ExcessiveOverkill/drive-software-dev/(list of files, cad)

Other CAD files:
KiCAD Files/HV servo drive v1 PCB.ipt
