ExcessiveOverkill/drive-software-dev/KiCAD Files/HV servo drive v1.kicad_pcb

## KiCad design KiCAD Files/HV servo drive v1.kicad_pcb (2024-05-03)

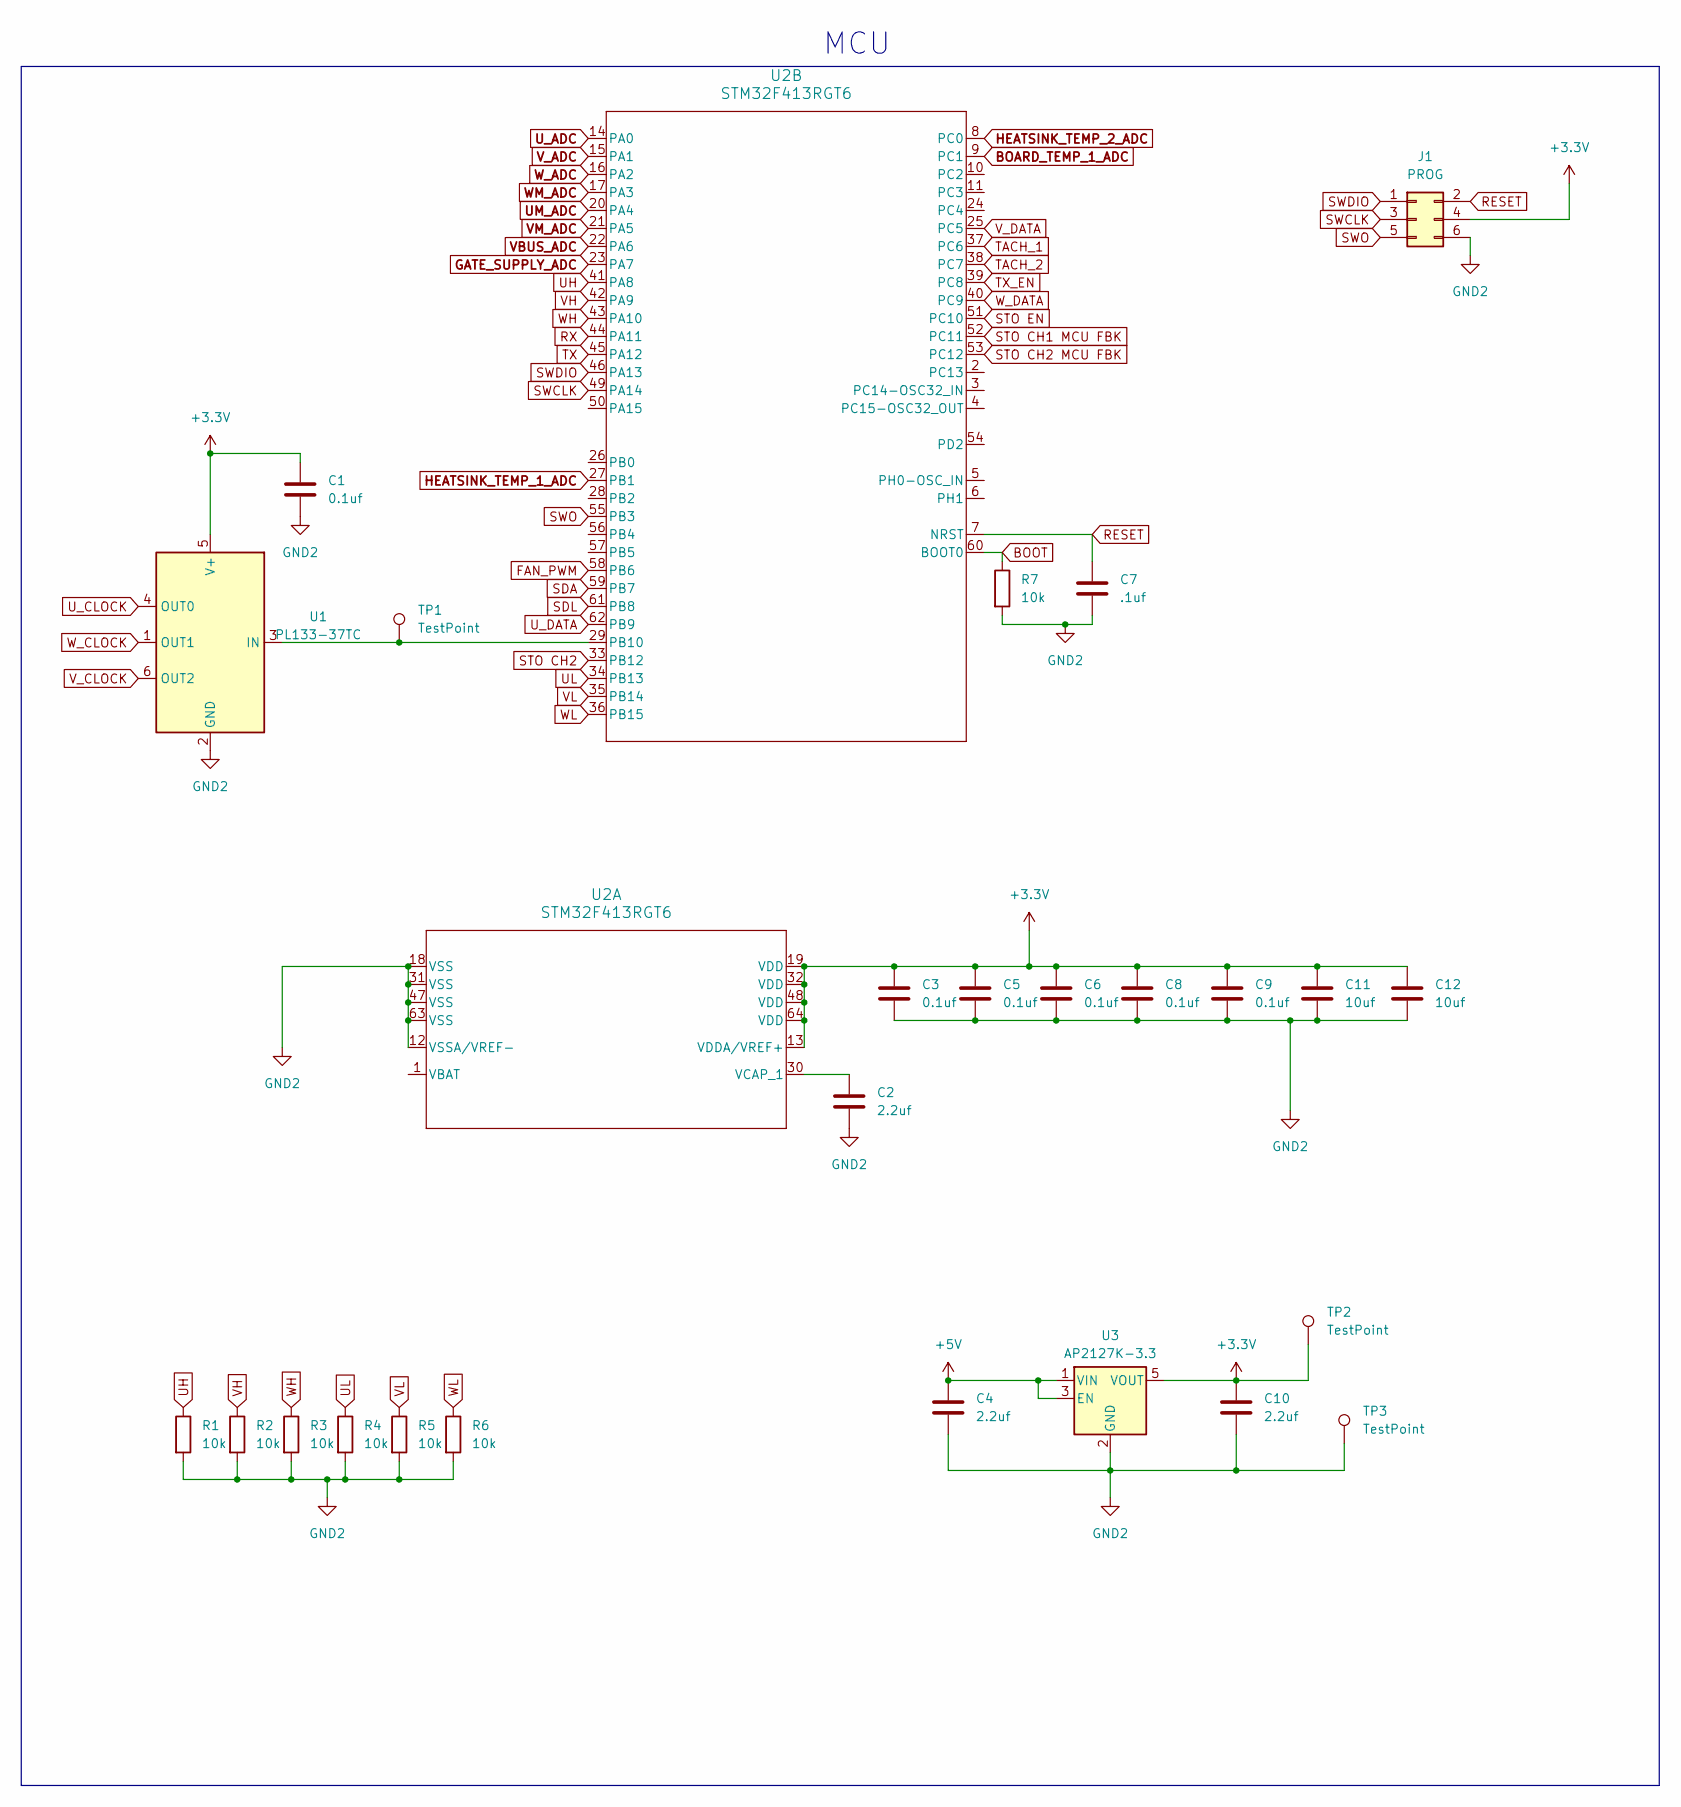
[picture p1: schematic mcu.kicad_sch]

Parts:
C1, C3, C5, C6, C8, C9: 0.1uf; C_0603_1608Metric
C2, C4, C10: 2.2uf; C_0603_1608Metric
C7: .1uf; C_0603_1608Metric
C11, C12: 10uf; C_0805_2012Metric
J1: PROG; PinHeader_2x03_P2.54mm_Vertical
R1, R2, R3, R4, R5, R6, R7: 10k; R_0603_1608Metric
TP1, TP2, TP3: TestPoint; TestPoint_Pad_3.1x1.6mm
U1: PL133-37TC; SOT-23-6
U2: STM32F413RGT6; LQFP64-10x10mm
U3: AP2127K-3.3; SOT-23-5

Connections:
+3.3V: C1.1, C3.1, C5.1, C6.1, C8.1, C9.1, C10.1, C11.1, C12.1, J1.4, TP2.1, U1.5 (V+), U2.13 (VDDA/VREF+), U2.19 (VDD), U2.32 (VDD), U2.48 (VDD), U2.64 (VDD), U3.5 (VOUT); also elsewhere on the board
+5V: C4.1, U3.1 (VIN), U3.3 (EN); also elsewhere on the board
BOARD_TEMP_1_ADC: U2.9 (PC1); also elsewhere on the board
BOOT: R7.1, U2.60 (BOOT0)
FAN_PWM: U2.58 (PB6); also elsewhere on the board
GATE_SUPPLY_ADC: U2.23 (PA7)
GND2: C1.2, C2.2, C3.2, C4.2, C5.2, C6.2, C7.2, C8.2, C9.2, C10.2, C11.2, C12.2, J1.6, R1.2, R2.2, R3.2, R4.2, R5.2, R6.2, R7.2, TP3.1, U1.2 (GND), U2.12 (VSSA/VREF-), U2.18 (VSS), U2.31 (VSS), U2.47 (VSS), U2.63 (VSS), U3.2 (GND); also elsewhere on the board
HEATSINK_TEMP_1_ADC: U2.27 (PB1); also elsewhere on the board
HEATSINK_TEMP_2_ADC: U2.8 (PC0); also elsewhere on the board
unnamed: TP1.1, U1.3 (IN), U2.29 (PB10)
unnamed: C2.1, U2.30 (VCAP_1)
RESET: C7.1, J1.2, U2.7 (NRST)
RX: U2.44 (PA11); also elsewhere on the board
SDA: U2.59 (PB7); also elsewhere on the board
SDL: U2.61 (PB8); also elsewhere on the board
STO CH1 MCU FBK: U2.52 (PC11); also elsewhere on the board
STO CH2: U2.33 (PB12); also elsewhere on the board
STO CH2 MCU FBK: U2.53 (PC12); also elsewhere on the board
STO EN: U2.51 (PC10); also elsewhere on the board
SWCLK: J1.3, U2.49 (PA14)
SWDIO: J1.1, U2.46 (PA13)
SWO: J1.5, U2.55 (PB3)
TACH_1: U2.37 (PC6); also elsewhere on the board
TACH_2: U2.38 (PC7); also elsewhere on the board
TX: U2.45 (PA12); also elsewhere on the board
TX_EN: U2.39 (PC8); also elsewhere on the board
UH: R1.1, U2.41 (PA8); also elsewhere on the board
UL: R4.1, U2.34 (PB13); also elsewhere on the board
UM_ADC: U2.20 (PA4); also elsewhere on the board
U_ADC: U2.14 (PA0); also elsewhere on the board
U_CLOCK: U1.4 (OUT0); also elsewhere on the board
U_DATA: U2.62 (PB9); also elsewhere on the board
VBUS_ADC: U2.22 (PA6); also elsewhere on the board
VH: R2.1, U2.42 (PA9); also elsewhere on the board
VL: R5.1, U2.35 (PB14); also elsewhere on the board
VM_ADC: U2.21 (PA5); also elsewhere on the board
V_ADC: U2.15 (PA1); also elsewhere on the board
V_CLOCK: U1.6 (OUT2); also elsewhere on the board
V_DATA: U2.25 (PC5); also elsewhere on the board
WH: R3.1, U2.43 (PA10); also elsewhere on the board
WL: R6.1, U2.36 (PB15); also elsewhere on the board
WM_ADC: U2.17 (PA3); also elsewhere on the board
W_ADC: U2.16 (PA2); also elsewhere on the board
W_CLOCK: U1.1 (OUT1); also elsewhere on the board
W_DATA: U2.40 (PC9); also elsewhere on the board

Notes on the sheet:
MCU

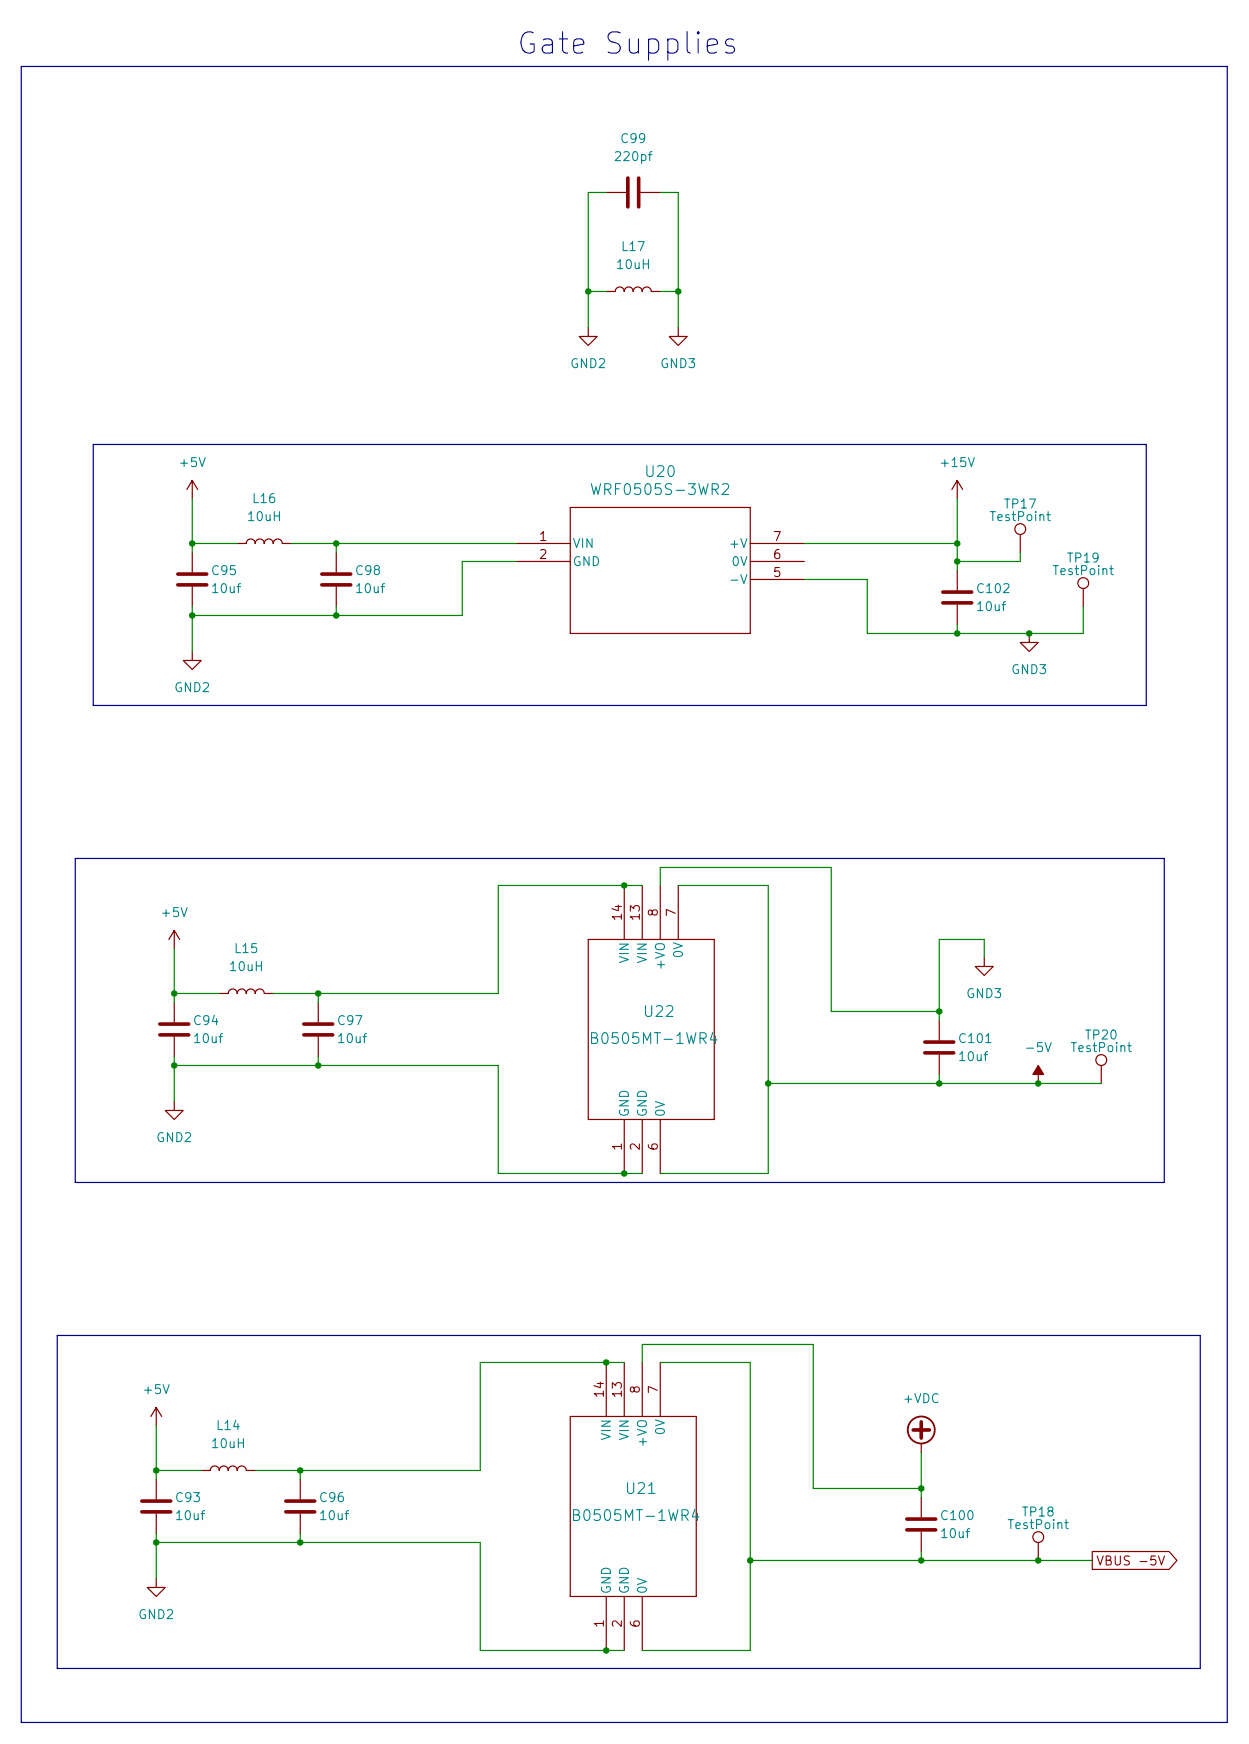
[picture p2: schematic gate supplies.kicad_sch]

Parts:
C93, C94, C95, C96, C97, C98, C100, C101, C102: 10uf; C_0805_2012Metric
C99: 220pf; C_0603_1608Metric
L14, L15, L16, L17: 10uH; L_1008_2520Metric
TP17, TP18, TP19, TP20: TestPoint; TestPoint_Pad_3.1x1.6mm
U20: WRF0505S-3WR2; B0515
U21, U22: B0505MT-1WR4; B05xxMT-1WR4_MNS

Connections:
+5V: C93.1, C94.1, C95.1, L14.1, L15.1, L16.1; also elsewhere on the board
+15V: C102.1, TP17.1, U20.7 (+V); also elsewhere on the board
+VDC: C100.1, U21.8 (+VO); also elsewhere on the board
-5V: C101.2, TP20.1, U22.6 (0V), U22.7 (0V); also elsewhere on the board
GND2: C93.2, C94.2, C95.2, C96.2, C97.2, C98.2, C99.2, L17.1, U20.2 (GND), U21.1 (GND), U21.2 (GND), U22.1 (GND), U22.2 (GND); also elsewhere on the board
GND3: C99.1, C101.1, C102.2, L17.2, TP19.1, U20.5 (-V), U22.8 (+VO); also elsewhere on the board
unnamed: C96.1, L14.2, U21.13 (VIN), U21.14 (VIN)
unnamed: C97.1, L15.2, U22.13 (VIN), U22.14 (VIN)
unnamed: C98.1, L16.2, U20.1 (VIN)
VBUS -5V: C100.2, TP18.1, U21.6 (0V), U21.7 (0V); also elsewhere on the board

Notes on the sheet:
Gate Supplies

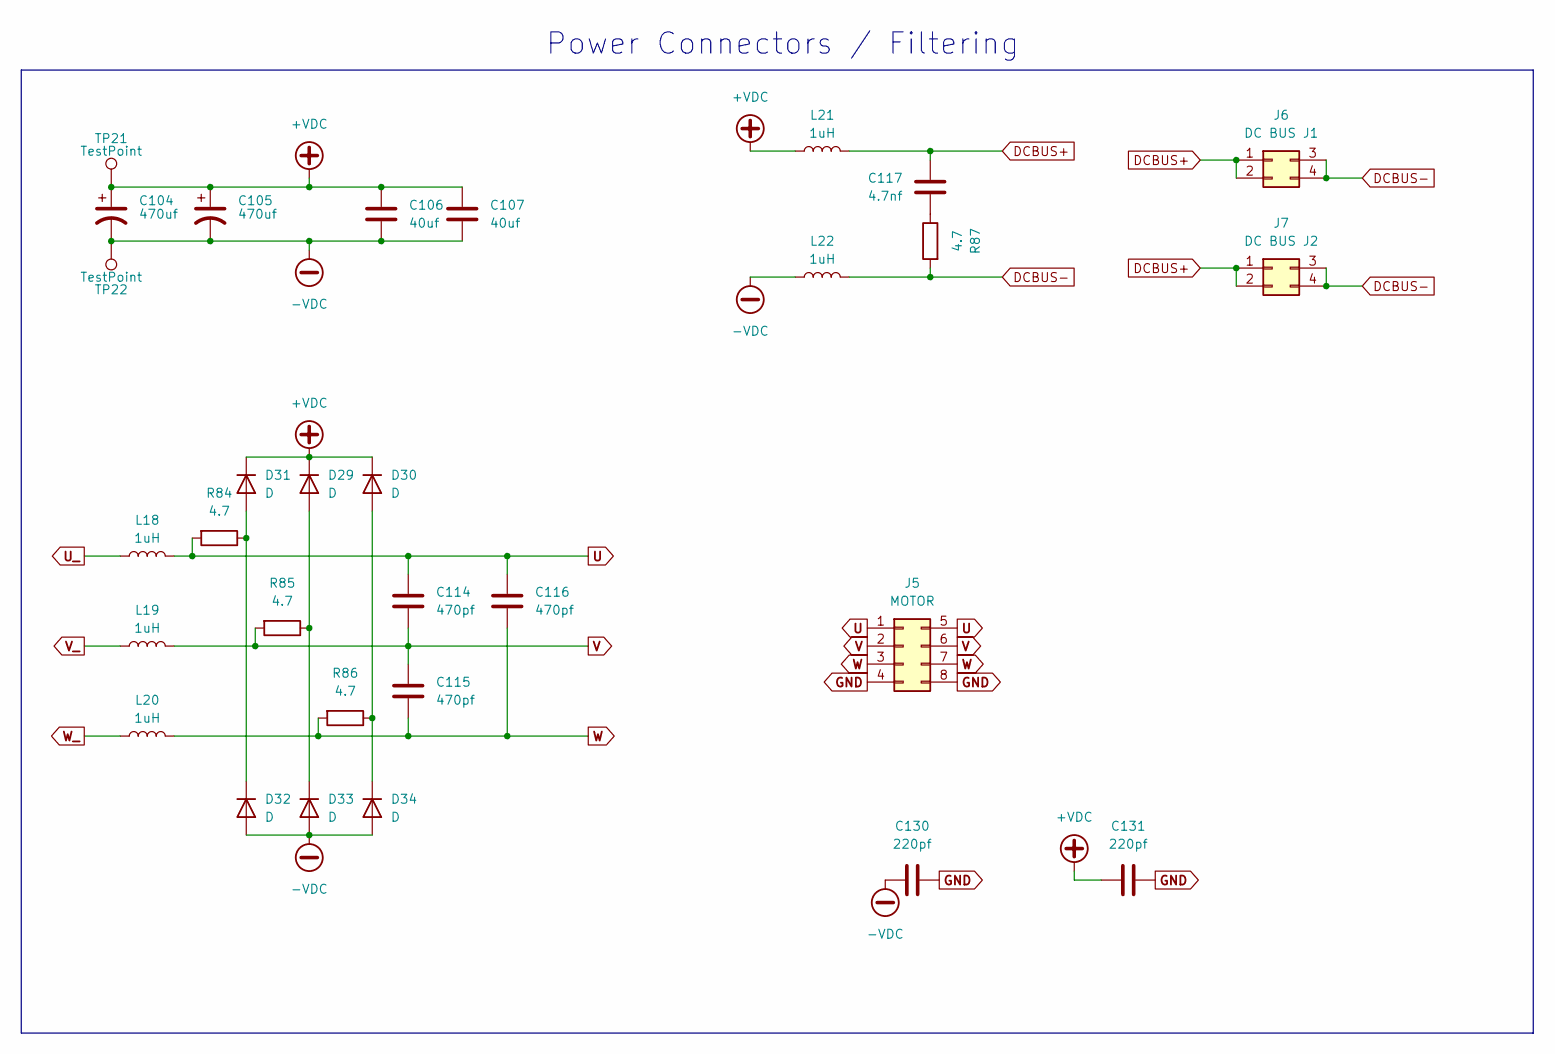
[picture p3: schematic power connectors.kicad_sch]

Parts:
C104, C105: 470uf; CP_Radial_D30.0mm_P10.00mm_SnapIn
C106, C107: 40uf; BUS CAP1
C114, C115, C116: 470pf; C_1206_3216Metric
C117: 4.7nf; C_1206_3216Metric
C130, C131: 220pf; C_Disc_D7.5mm_W5.0mm_P10.00mm
D29, D30, D31, D32, D33, D34: D; D_SMC
J5: MOTOR; Molex_Mega-Fit_76825-0008_2x04_P5.70mm_Horizontal
J6: DC BUS J1; Molex_Mega-Fit_76825-0004_2x02_P5.70mm_Horizontal
J7: DC BUS J2; Molex_Mega-Fit_76825-0004_2x02_P5.70mm_Horizontal
L18, L19, L20: 1uH; L_Vishay_IHLP-6767
L21, L22: 1uH; L_Vishay_IHLP-5050
R84, R85, R86, R87: 4.7; R_1206_3216Metric_Wide
TP21, TP22: TestPoint; TestPoint_Pad_3.1x1.6mm

Connections:
+VDC: C104.1, C105.1, C106.1, C107.1, C131.2, D29.1 (K), D30.1 (K), D31.1 (K), L21.2, TP21.1; also elsewhere on the board
-VDC: C104.2, C105.2, C106.2, C107.2, C130.2, D32.2 (A), D33.2 (A), D34.2 (A), L22.2, TP22.1; also elsewhere on the board
DCBUS+: C117.1, J6.1, J6.2, J7.1, J7.2, L21.1
DCBUS-: J6.3, J6.4, J7.3, J7.4, L22.1, R87.2
GND: C130.1, C131.1, J5.4, J5.8; also elsewhere on the board
unnamed: C117.2, R87.1
unnamed: D29.2 (A), D33.1 (K), R85.1
unnamed: D30.2 (A), D34.1 (K), R86.1
unnamed: D31.2 (A), D32.1 (K), R84.1
U: C114.1, C116.1, J5.1, J5.5, L18.2, R84.2; also elsewhere on the board
U_: L18.1; also elsewhere on the board
V: C114.2, C115.1, J5.2, J5.6, L19.2, R85.2; also elsewhere on the board
V_: L19.1; also elsewhere on the board
W: C115.2, C116.2, J5.3, J5.7, L20.2, R86.2; also elsewhere on the board
W_: L20.1; also elsewhere on the board

Notes on the sheet:
Power Connectors / Filtering

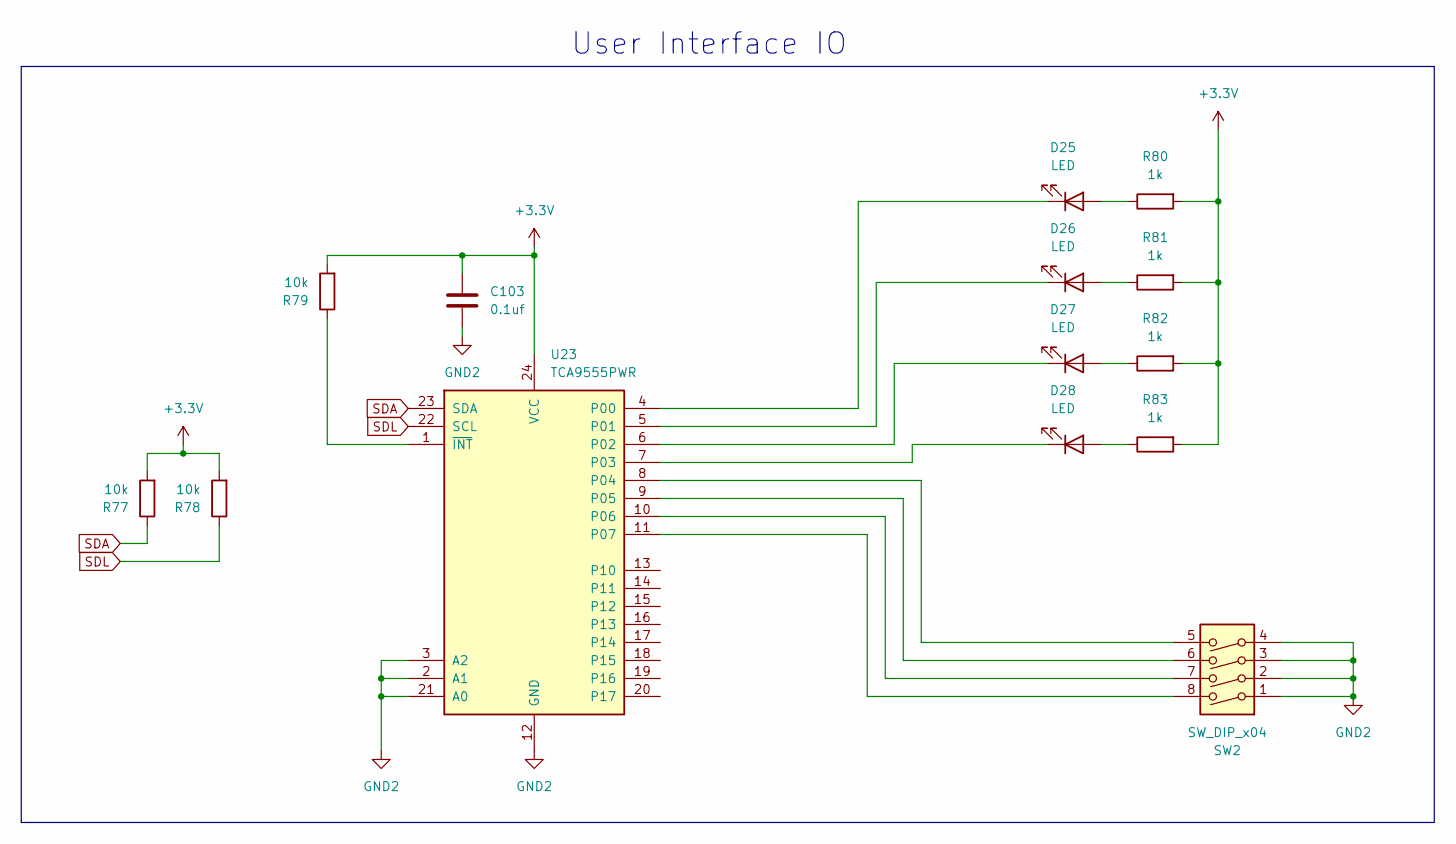
[picture p4: schematic user io.kicad_sch]

Parts:
C103: 0.1uf; C_0603_1608Metric
D25, D26, D27, D28: LED; LED_0603_1608Metric
R77, R78, R79: 10k; R_0603_1608Metric
R80, R81, R82, R83: 1k; R_0603_1608Metric
SW2: SW_DIP_x04; DIP-8_W7.62mm
U23: TCA9555PWR; TSSOP-24_4.4x7.8mm_P0.65mm

Connections:
+3.3V: C103.1, R77.2, R78.2, R79.2, R80.2, R81.2, R82.2, R83.2, U23.24 (VCC); also elsewhere on the board
GND2: C103.2, SW2.1, SW2.2, SW2.3, SW2.4, U23.2 (A1), U23.3 (A2), U23.12 (GND), U23.21 (A0); also elsewhere on the board
unnamed: D25.2 (A), R80.1
unnamed: D25.1 (K), U23.4 (P00)
unnamed: D26.2 (A), R81.1
unnamed: D26.1 (K), U23.5 (P01)
unnamed: D27.2 (A), R82.1
unnamed: D27.1 (K), U23.6 (P02)
unnamed: D28.2 (A), R83.1
unnamed: D28.1 (K), U23.7 (P03)
unnamed: SW2.5, U23.8 (P04)
unnamed: SW2.6, U23.9 (P05)
unnamed: SW2.7, U23.10 (P06)
unnamed: SW2.8, U23.11 (P07)
unnamed: R79.1, U23.1 (~INT)
SDA: R77.1, U23.23 (SDA); also elsewhere on the board
SDL: R78.1, U23.22 (SCL); also elsewhere on the board

Notes on the sheet:
User Interface IO

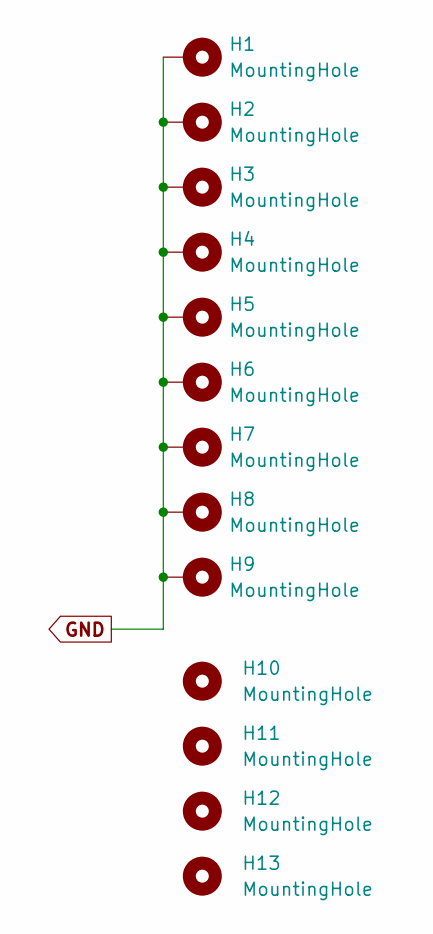
[picture p5: schematic mounting.kicad_sch]

Parts:
H1, H2, H3, H4, H5, H6, H7, H8, H9, H10, H11, H12, H13: MountingHole; MountingHole_3.2mm_M3_Pad_TopBottom_LargeIsolation

Connections:
GND: H1.1, H2.1, H3.1, H4.1, H5.1, H6.1, H7.1, H8.1, H9.1; also elsewhere on the board

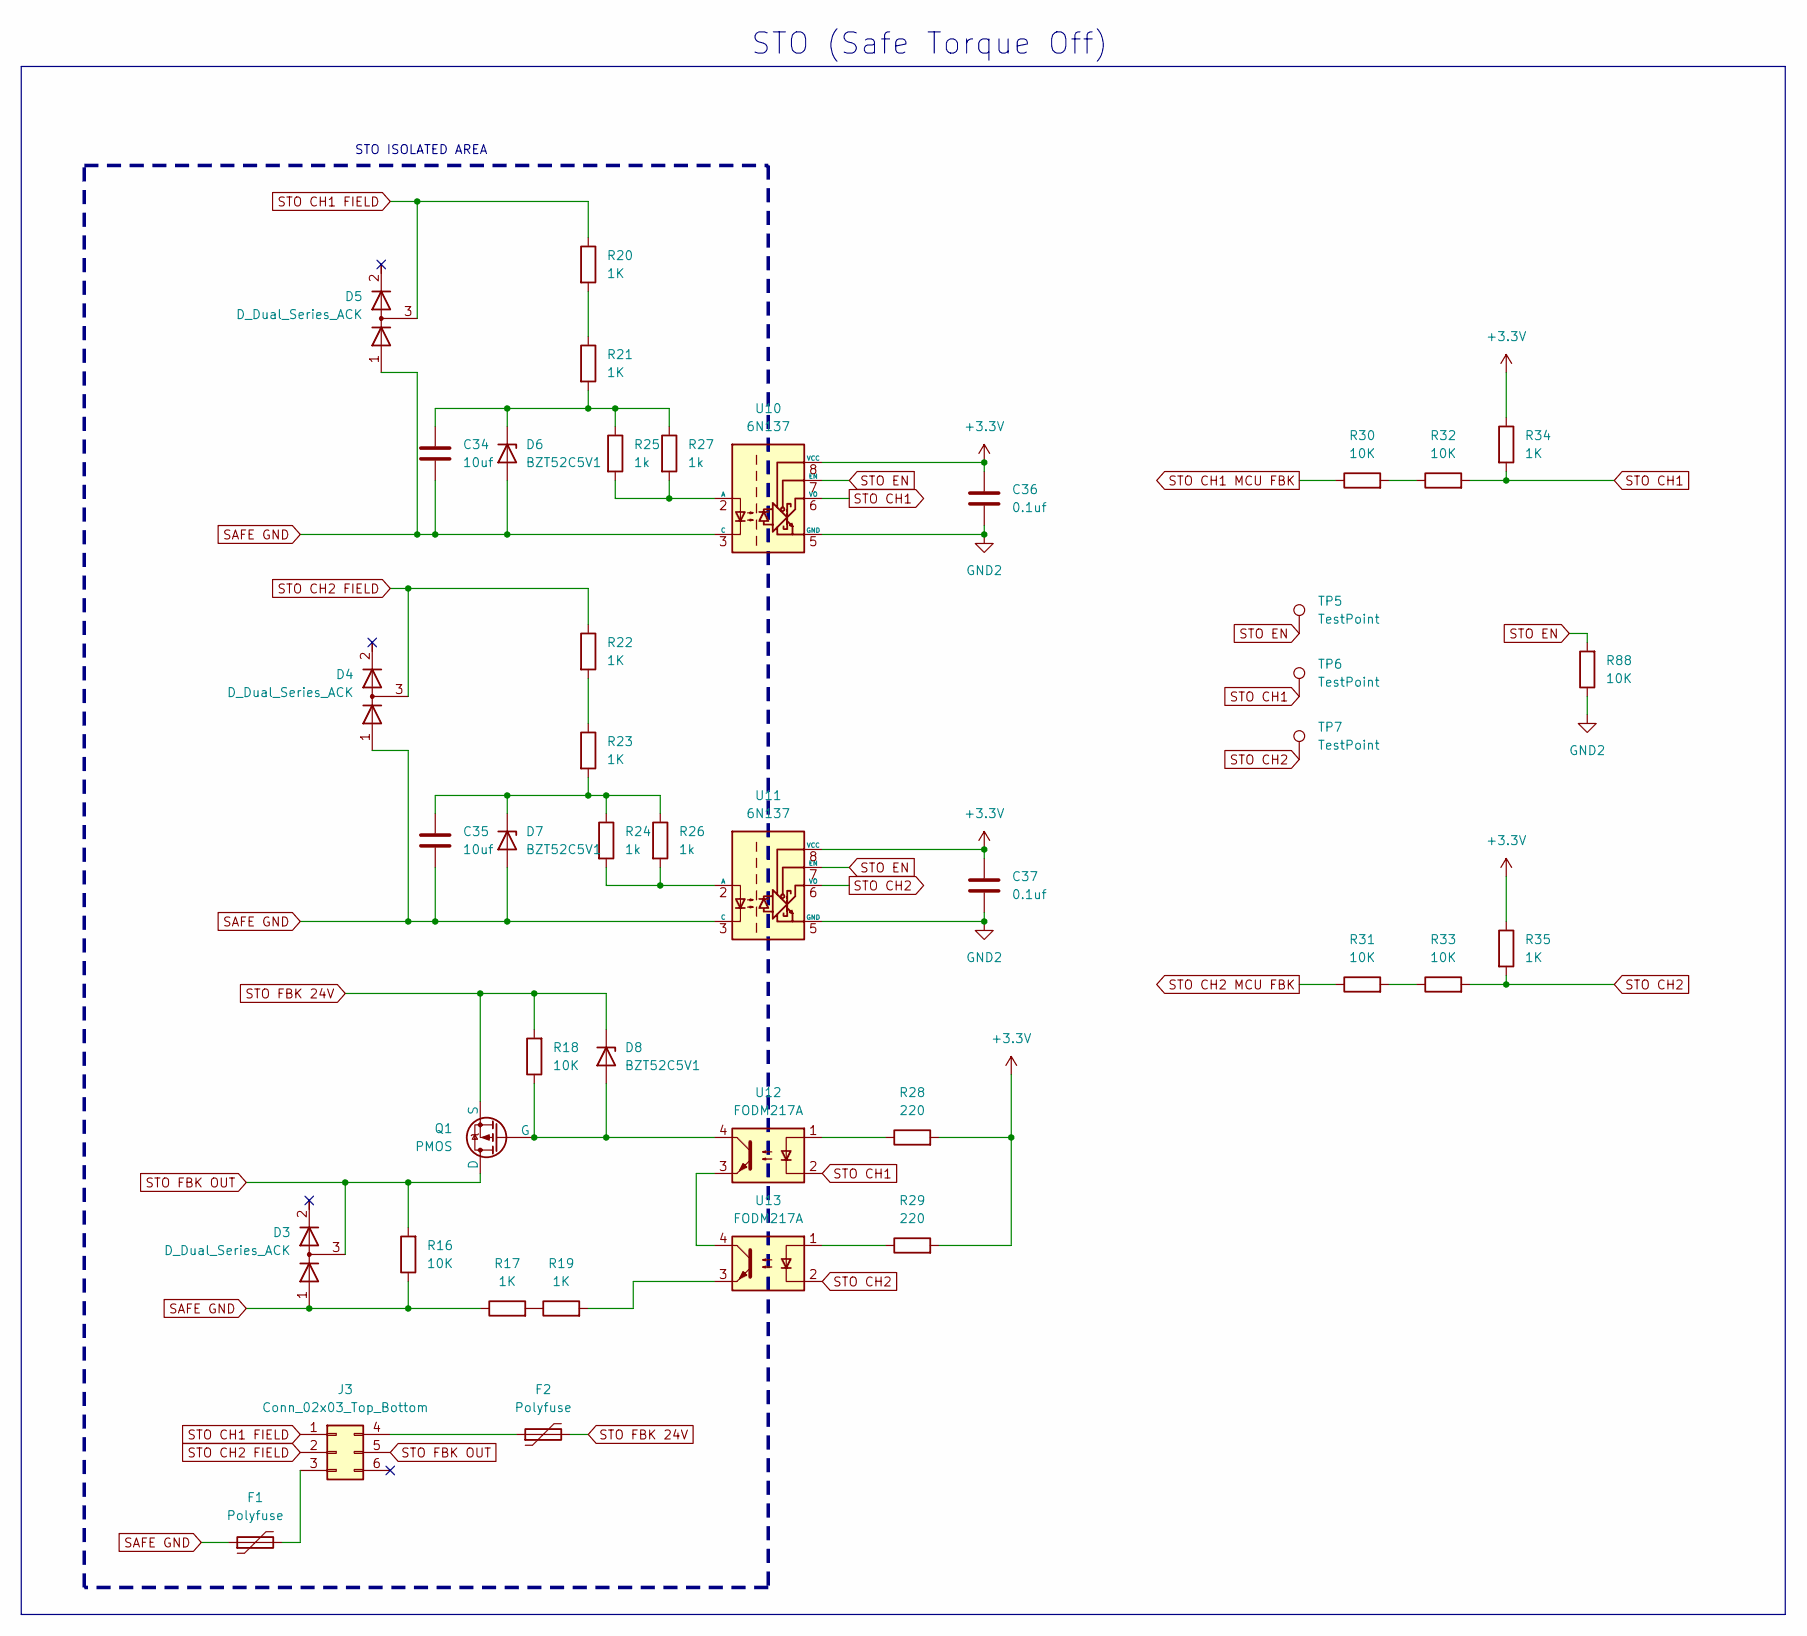
[picture p6: schematic sto.kicad_sch]

Parts:
C34, C35: 10uf; C_0805_2012Metric
C36, C37: 0.1uf; C_0603_1608Metric
D3, D4, D5: D_Dual_Series_ACK; SOT-23
D6, D7, D8: BZT52C5V1; D_SOD-123
F1, F2: Polyfuse; Fuse_1206_3216Metric
J3: Conn_02x03_Top_Bottom; Molex_Mini-Fit_Jr_5569-06A2_2x03_P4.20mm_Horizontal
Q1: PMOS; SOIC-8_3.9x4.9mm_P1.27mm
R16, R18, R30, R31, R32, R33, R88: 10K; R_0603_1608Metric
R17, R19, R20, R21, R22, R23, R34, R35: 1K; R_0603_1608Metric
R24, R25, R26, R27: 1k; R_0603_1608Metric
R28, R29: 220; R_0603_1608Metric
TP5, TP6, TP7: TestPoint; TestPoint_Pad_3.1x1.6mm
U10, U11: 6N137; 6N137S_LTO
U12, U13: FODM217A; SOP-4_4.4x2.6mm_P1.27mm

Connections:
+3.3V: C36.1, C37.1, R28.2, R29.2, R34.1, R35.1, U10.8 (VCC), U11.8 (VCC); also elsewhere on the board
GND2: C36.2, C37.2, R88.1, U10.5 (GND), U11.5 (GND); also elsewhere on the board
unnamed: C34.1, D6.1 (K), R21.2, R25.1, R27.1
unnamed: C35.1, D7.1 (K), R23.2, R24.1, R26.1
unnamed: D8.2 (A), Q1.4 (G), R18.1, U12.4
unnamed: F1.2, J3.3
unnamed: F2.1, J3.4
unnamed: R17.2, R19.1
unnamed: R19.2, U13.3
unnamed: R20.2, R21.1
unnamed: R22.2, R23.1
unnamed: R28.1, U12.1
unnamed: R29.1, U13.1
unnamed: R30.2, R32.1
unnamed: R31.2, R33.1
unnamed: R25.2, R27.2, U10.2 (A)
unnamed: R24.2, R26.2, U11.2 (A)
unnamed: U12.3, U13.4
SAFE GND: C34.2, C35.2, D3.1 (A), D4.1 (A), D5.1 (A), D6.2 (A), D7.2 (A), F1.1, R16.1, R17.1, U10.3 (C), U11.3 (C)
STO CH1: R32.2, R34.2, TP6.1, U10.6 (VO), U12.2; also elsewhere on the board
STO CH1 FIELD: D5.3 (common), J3.1, R20.1
STO CH1 MCU FBK: R30.1; also elsewhere on the board
STO CH2: R33.2, R35.2, TP7.1, U11.6 (VO), U13.2; also elsewhere on the board
STO CH2 FIELD: D4.3 (common), J3.2, R22.1
STO CH2 MCU FBK: R31.1; also elsewhere on the board
STO EN: R88.2, TP5.1, U10.7 (EN), U11.7 (EN); also elsewhere on the board
STO FBK 24V: D8.1 (K), F2.2, Q1.1 (S), Q1.2 (S), Q1.3 (S), R18.2
STO FBK OUT: D3.3 (common), J3.5, Q1.5 (D), Q1.6 (D), Q1.7 (D), Q1.8 (D), R16.2

Notes on the sheet:
STO (Safe Torque Off)
STO ISOLATED AREA

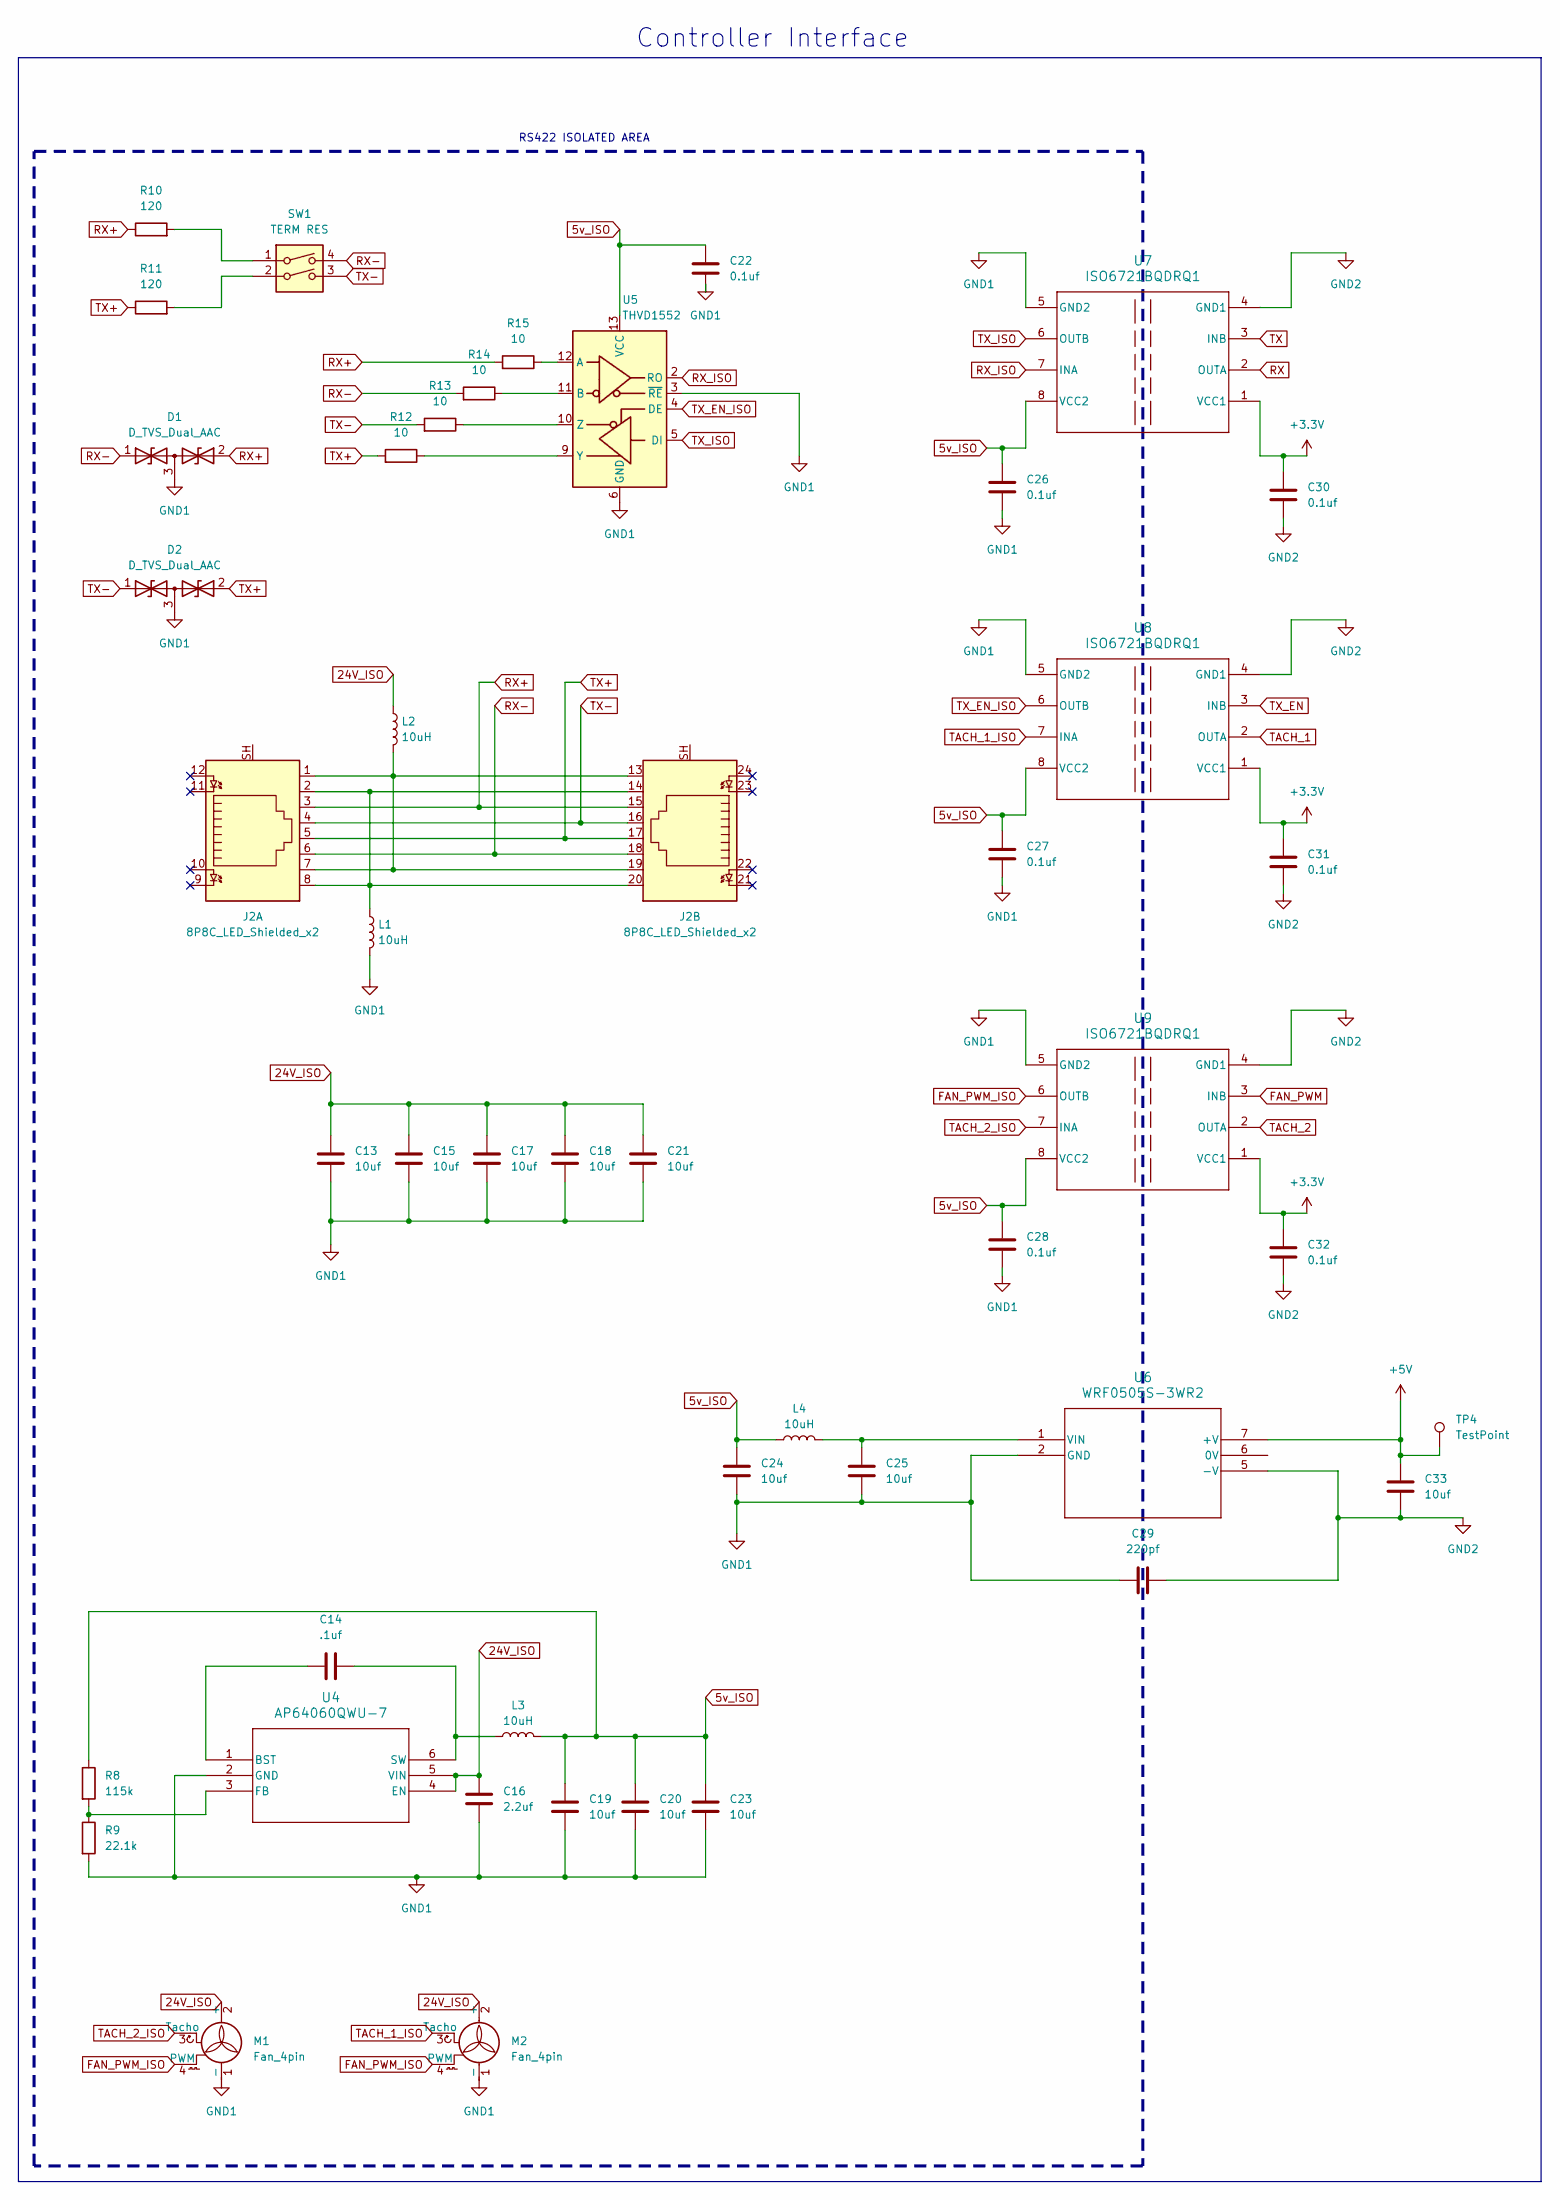
[picture p7: schematic controller interface.kicad_sch]

Parts:
C13, C15, C17, C18, C19, C20, C21, C23, C24, C25, C33: 10uf; C_0805_2012Metric
C14: .1uf; C_0603_1608Metric
C16: 2.2uf; C_0603_1608Metric
C22, C26, C27, C28, C30, C31, C32: 0.1uf; C_0603_1608Metric
C29: 220pf; C_Disc_D7.5mm_W5.0mm_P10.00mm
D1, D2: D_TVS_Dual_AAC; SOT-23
J2: 8P8C_LED_Shielded_x2; RJ45_E5908-0T0343-L
L1, L2, L3, L4: 10uH; L_1008_2520Metric
M1, M2: Fan_4pin; Molex_SPOX_5267-04A_1x04_P2.50mm_Vertical
R8: 115k; R_0603_1608Metric
R9: 22.1k; R_0603_1608Metric
R10, R11: 120; R_0603_1608Metric
R12, R13, R14, R15: 10; R_0603_1608Metric
SW1: TERM RES; DIP-4_W7.62mm
TP4: TestPoint; TestPoint_Pad_3.1x1.6mm
U4: AP64060QWU-7; IC6_AP64060QWU-7_DIO
U5: THVD1552; SOIC-14_3.9x8.7mm_P1.27mm
U6: WRF0505S-3WR2; F0505S-2WR3
U7, U8, U9: ISO6721BQDRQ1; SOICN-8_LTF

Connections:
5v_ISO: C19.1, C20.1, C22.1, C23.1, C24.1, C26.1, C27.1, C28.1, L3.2, L4.1, R8.1, U5.13 (VCC), U5.14 (VCC), U7.8 (VCC2), U8.8 (VCC2), U9.8 (VCC2)
24V_ISO: C13.1, C15.1, C16.1, C17.1, C18.1, C21.1, L2.1, M1.2 (+), M2.2 (+), U4.4 (EN), U4.5 (VIN)
+3.3V: C30.1, C31.1, C32.1, U7.1 (VCC1), U8.1 (VCC1), U9.1 (VCC1); also elsewhere on the board
+5V: C33.1, TP4.1, U6.7 (+V); also elsewhere on the board
FAN_PWM: U9.3 (INB); also elsewhere on the board
FAN_PWM_ISO: M1.4 (PWM), M2.4 (PWM), U9.6 (OUTB)
GND1: C13.2, C15.2, C16.2, C17.2, C18.2, C19.2, C20.2, C21.2, C22.2, C23.2, C24.2, C25.2, C26.2, C27.2, C28.2, C29.2, D1.3 (common), D2.3 (common), L1.2, M1.1 (-), M2.1 (-), R9.2, U4.2 (GND), U5.3 (~RE), U5.6 (GND), U5.7 (GND), U6.2 (GND), U7.5 (GND2), U8.5 (GND2), U9.5 (GND2)
GND2: C29.1, C30.2, C31.2, C32.2, C33.2, U6.5 (-V), U7.4 (GND1), U8.4 (GND1), U9.4 (GND1); also elsewhere on the board
unnamed: J2.1, J2.7, J2.13, J2.19, L2.2
unnamed: J2.2, J2.8, J2.14, J2.20, L1.1
unnamed: R10.2, SW1.1
unnamed: R11.2, SW1.2
unnamed: C14.1, U4.1 (BST)
unnamed: R8.2, R9.1, U4.3 (FB)
unnamed: C14.2, L3.1, U4.6 (SW)
unnamed: R15.1, U5.12 (A)
unnamed: R14.1, U5.11 (B)
unnamed: R12.1, U5.9 (Y)
unnamed: R13.1, U5.10 (Z)
unnamed: C25.1, L4.2, U6.1 (VIN)
RX: U7.2 (OUTA); also elsewhere on the board
RX+: D1.2 (A2), J2.3, J2.15, R10.1, R15.2
RX-: D1.1 (A1), J2.6, J2.18, R14.2, SW1.4
RX_ISO: U5.2 (RO), U7.7 (INA)
TACH_1: U8.2 (OUTA); also elsewhere on the board
TACH_1_ISO: M2.3 (Tacho), U8.7 (INA)
TACH_2: U9.2 (OUTA); also elsewhere on the board
TACH_2_ISO: M1.3 (Tacho), U9.7 (INA)
TX: U7.3 (INB); also elsewhere on the board
TX+: D2.2 (A2), J2.5, J2.17, R11.1, R12.2
TX-: D2.1 (A1), J2.4, J2.16, R13.2, SW1.3
TX_EN: U8.3 (INB); also elsewhere on the board
TX_EN_ISO: U5.4 (DE), U8.6 (OUTB)
TX_ISO: U5.5 (DI), U7.6 (OUTB)

Notes on the sheet:
RS422 ISOLATED AREA
Controller Interface
