ExcessiveOverkill/drive-software-dev/KiCAD Files/HV servo drive v1.kicad_pcb

## KiCad design KiCAD Files/HV servo drive v1.kicad_pcb (continued)

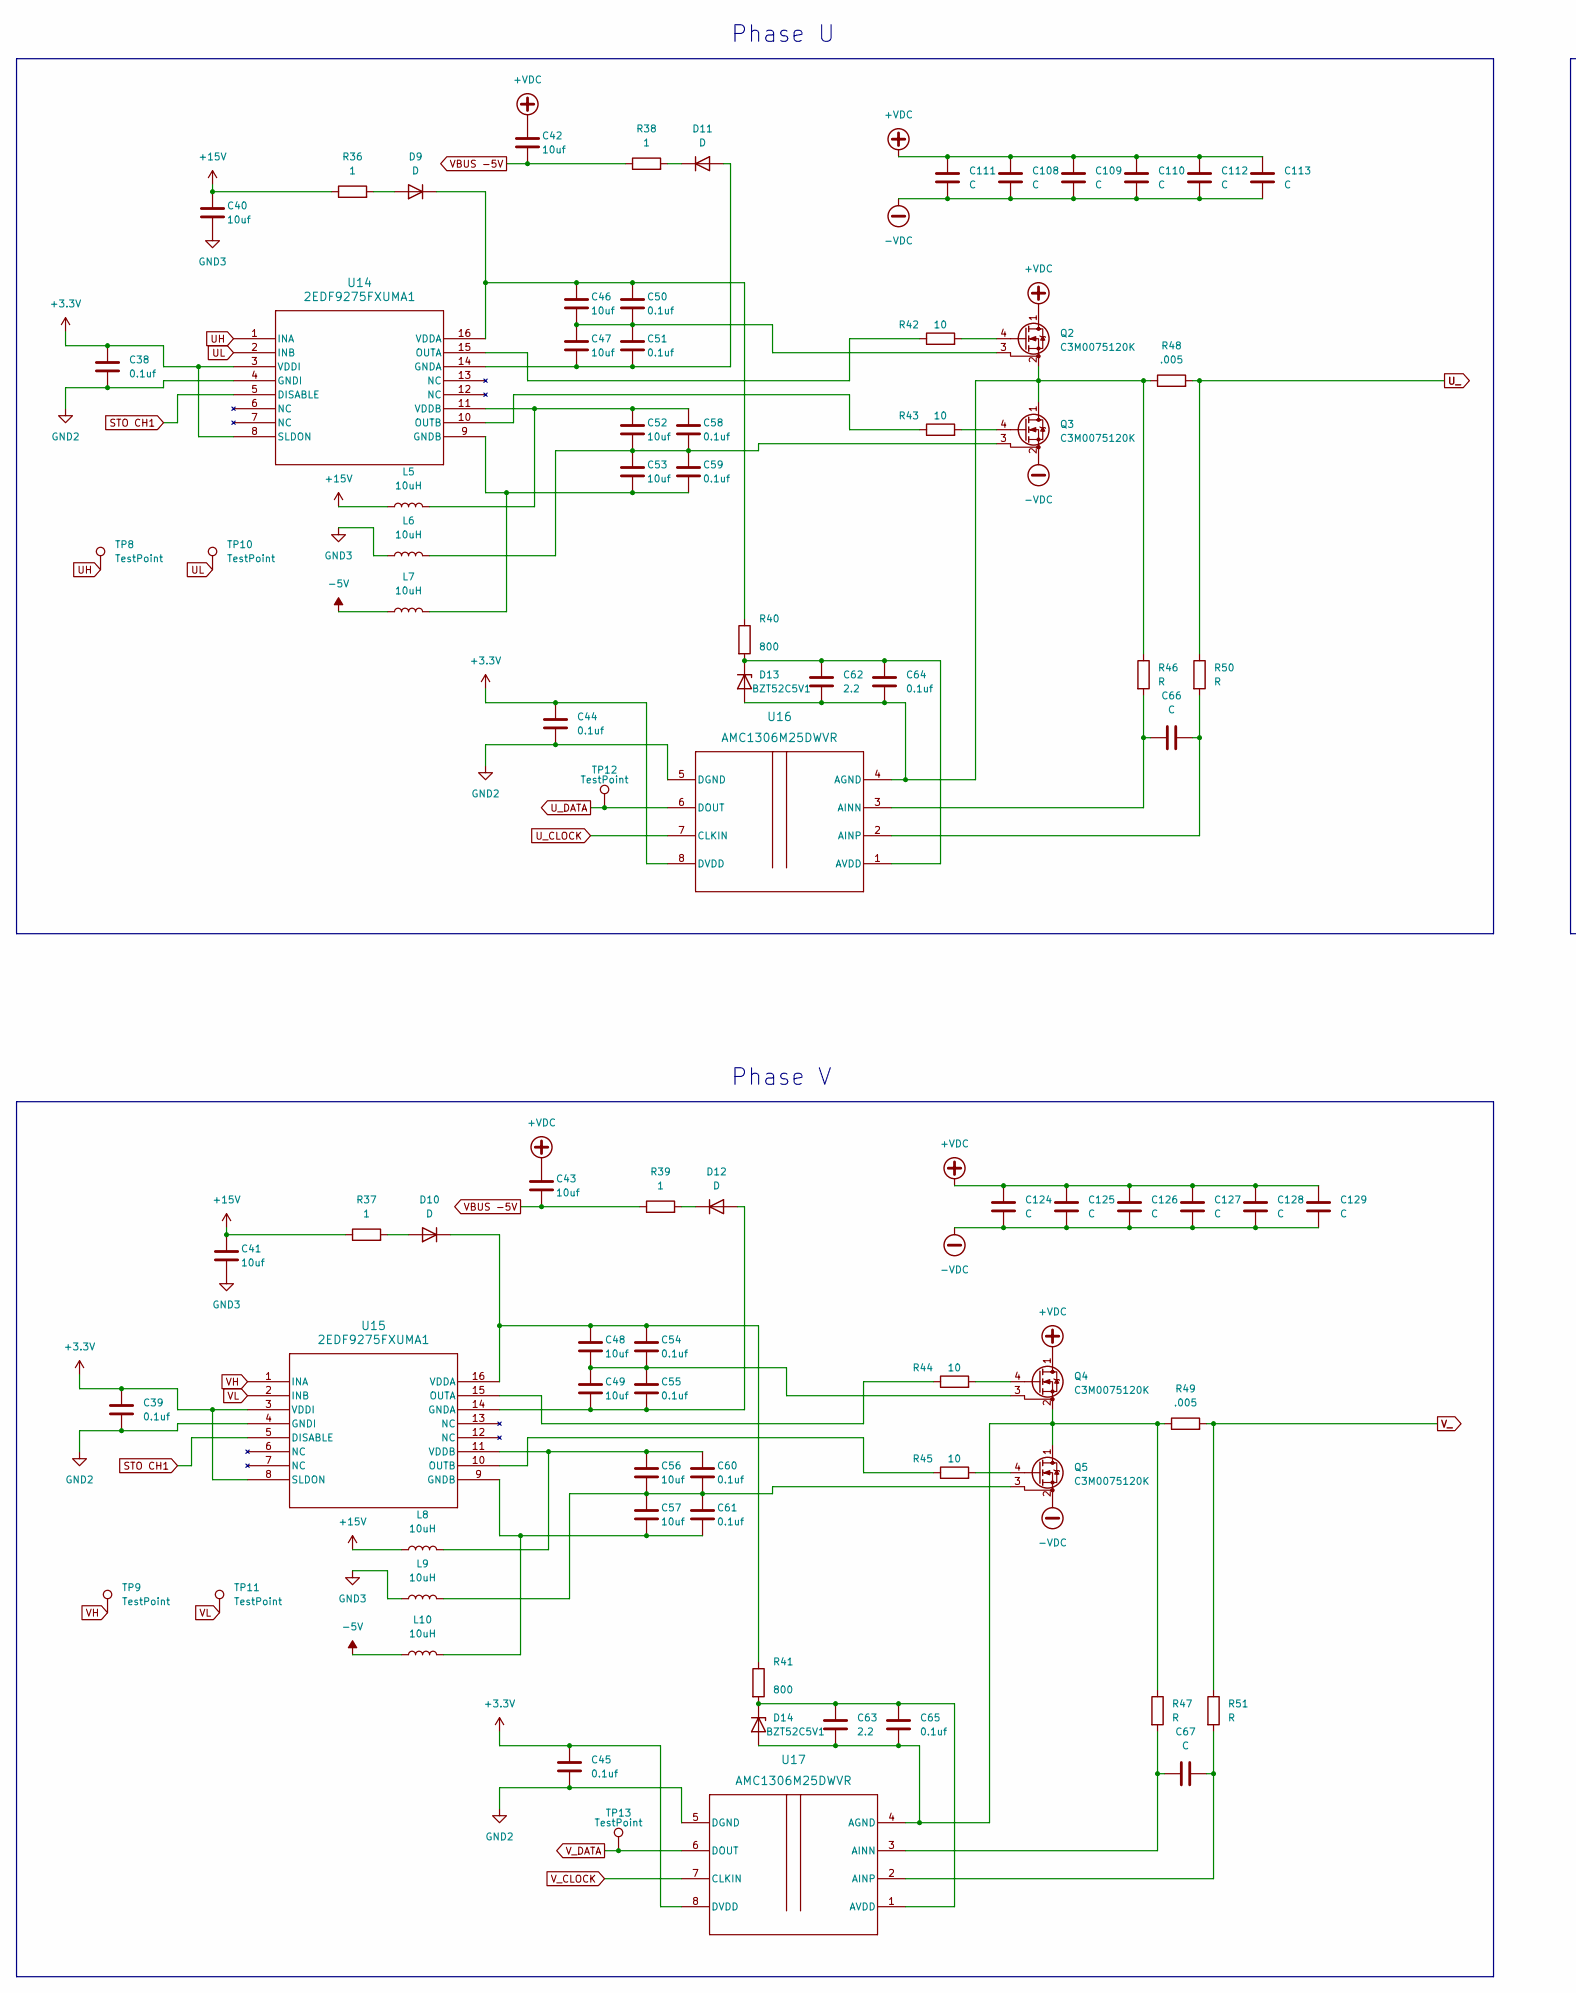
[picture p8: schematic phase bridges.kicad_sch, part in row 1, column 1]

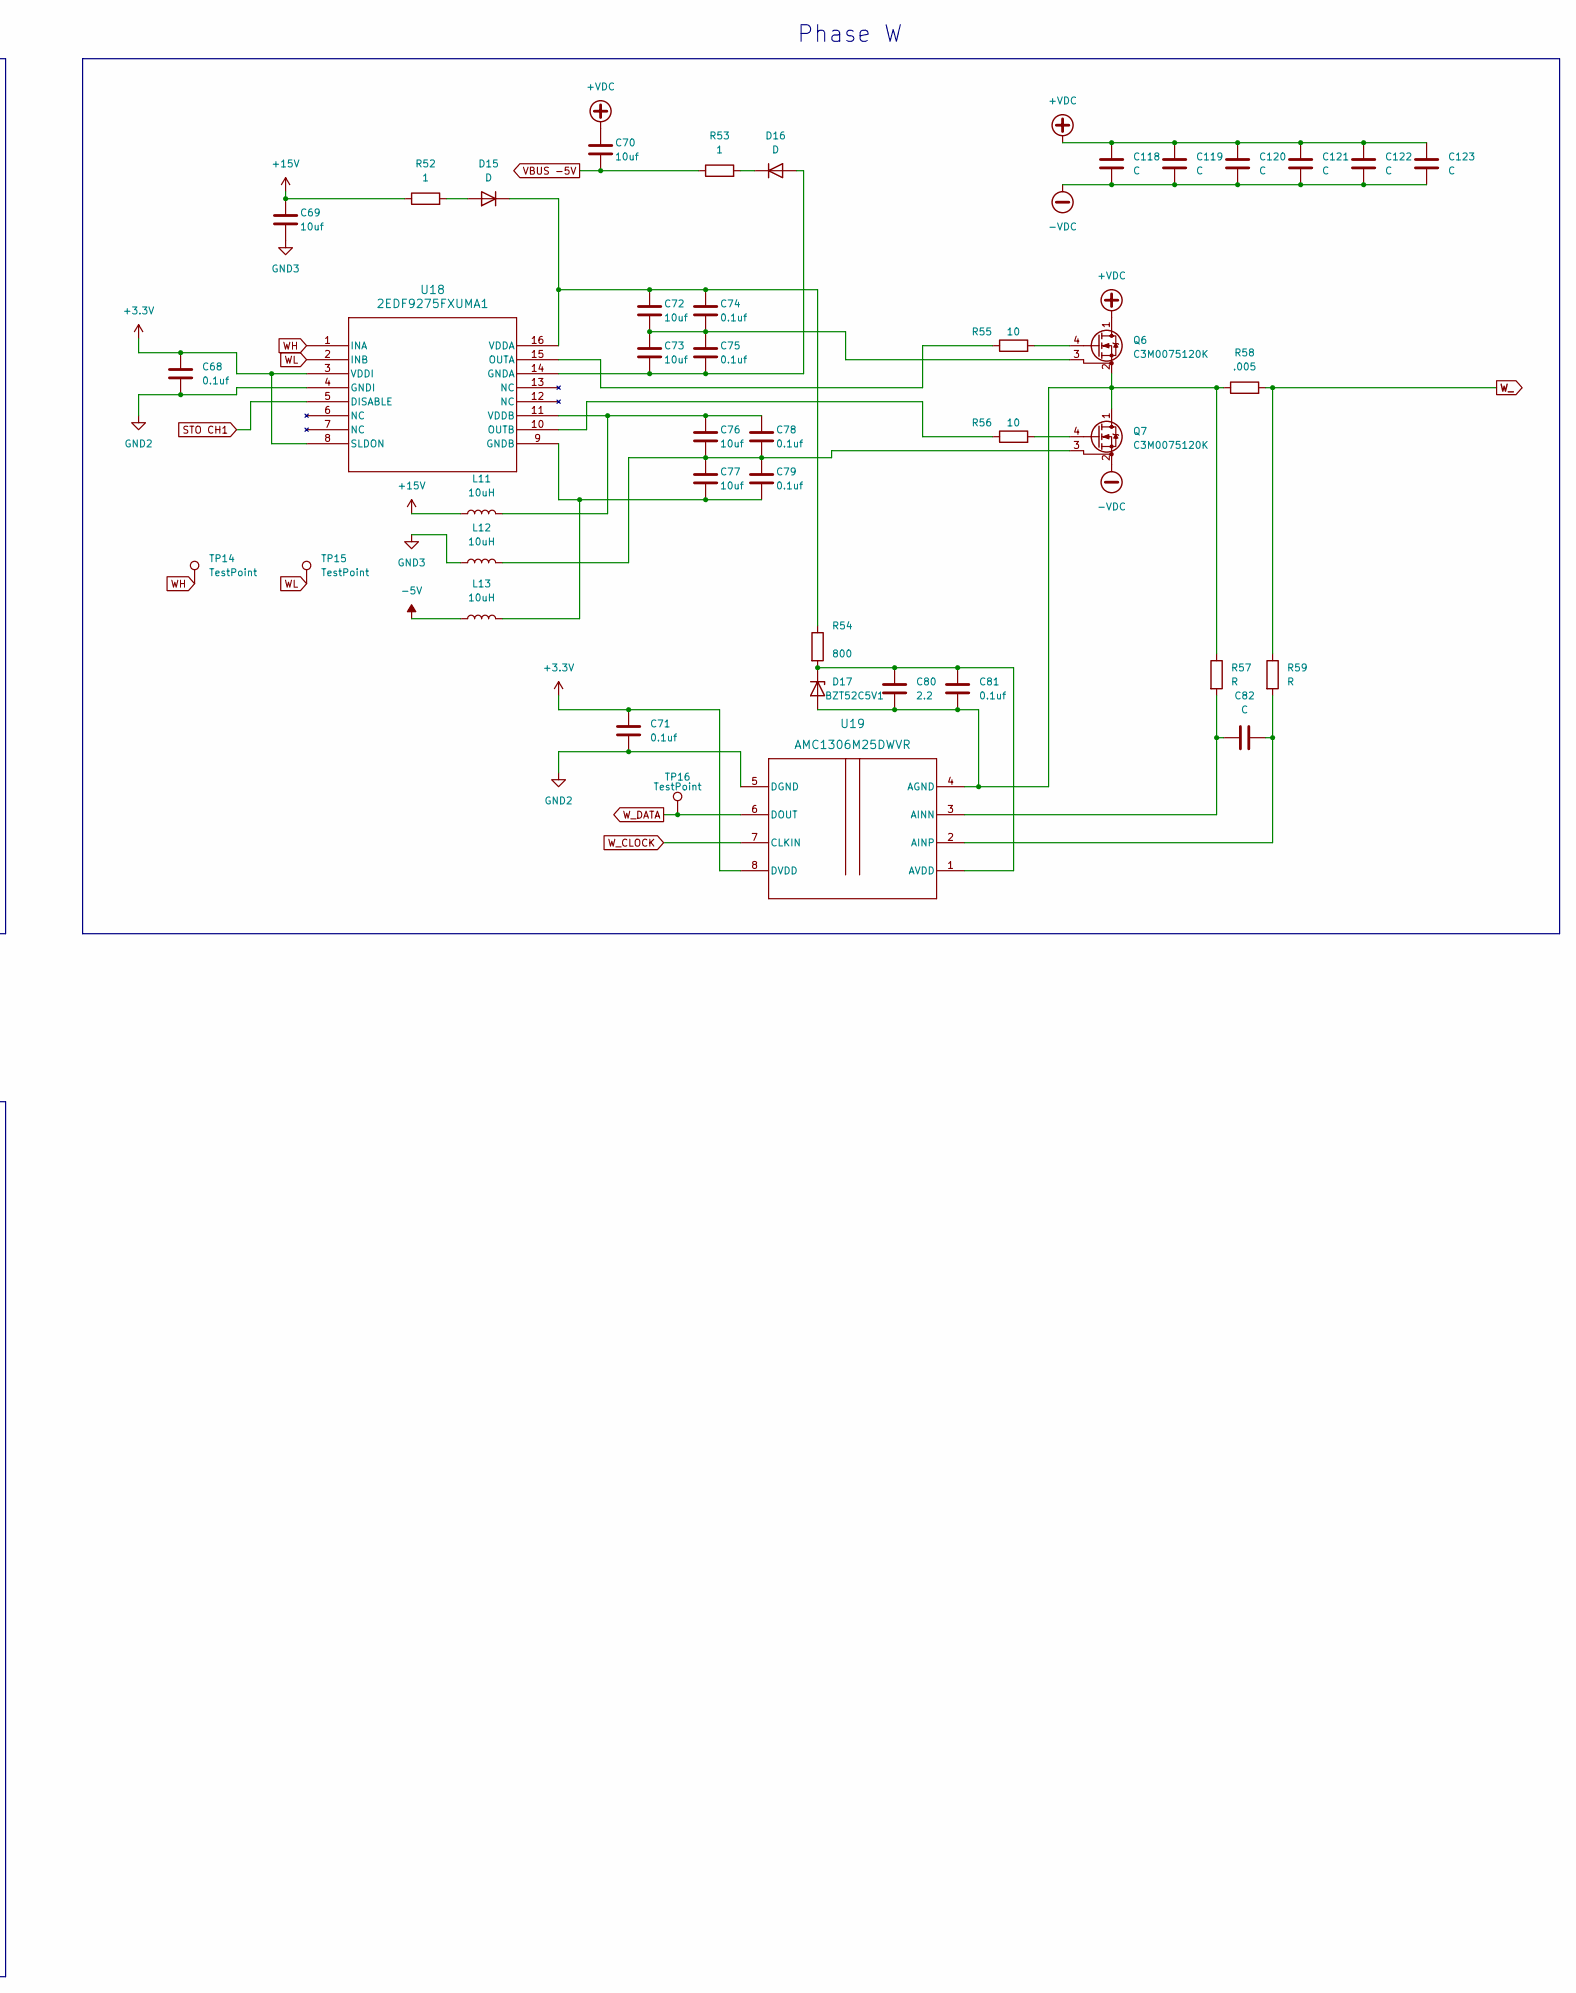
[picture p9: schematic phase bridges.kicad_sch, part in row 1, column 2]

Parts:
C38, C39, C44, C45, C50, C51, C54, C55, C58, C59, C60, C61, C64, C65, C68, C71, C74, C75, C78, C79, C81: 0.1uf; C_0603_1608Metric
C40, C41, C42, C43, C46, C47, C48, C49, C52, C53, C56, C57, C69, C70, C72, C73, C76, C77: 10uf; C_0805_2012Metric
C62, C63, C80: 2.2; C_0603_1608Metric
C66, C67, C82: C; C_0603_1608Metric
C108, C109, C110, C111, C112, C113, C118, C119, C120, C121, C122, C123, C124, C125, C126, C127, C128, C129: C; C_1210_3225Metric
D9, D10, D11, D12, D15, D16: D; D_SMB
D13, D14, D17: BZT52C5V1; D_SOD-123
L5, L6, L7, L8, L9, L10, L11, L12, L13: 10uH; L_0603_1608Metric
Q2, Q3, Q4, Q5, Q6, Q7: C3M0075120K; TO-247-4_Horizontal_TabUp
R36, R37, R38, R39, R52, R53: 1; R_0805_2012Metric
R40, R41, R54: 800; R_0805_2012Metric
R42, R43, R44, R45, R55, R56: 10; R_1206_3216Metric
R46, R47, R50, R51, R57, R59: R; R_0603_1608Metric
R48, R49, R58: .005; RES_HCSM2818_STP
TP8, TP9, TP10, TP11, TP12, TP13, TP14, TP15, TP16: TestPoint; TestPoint_Pad_3.1x1.6mm
U14, U15, U18: 2EDF9275FXUMA1; PG-DSO-16-11
U16, U17, U19: AMC1306M25DWVR; DWV0008A

Connections:
+3.3V: C38.1, C39.1, C44.1, C45.1, C68.1, C71.1, U14.3 (VDDI), U14.8 (SLDON), U15.3 (VDDI), U15.8 (SLDON), U16.8 (DVDD), U17.8 (DVDD), U18.3 (VDDI), U18.8 (SLDON), U19.8 (DVDD); also elsewhere on the board
+15V: C40.1, C41.1, C69.1, L5.1, L8.1, L11.1, R36.1, R37.1, R52.1; also elsewhere on the board
+VDC: C42.1, C43.1, C70.1, C108.1, C109.1, C110.1, C111.1, C112.1, C113.1, C118.1, C119.1, C120.1, C121.1, C122.1, C123.1, C124.1, C125.1, C126.1, C127.1, C128.1, C129.1, Q2.1 (D), Q4.1 (D), Q6.1 (D); also elsewhere on the board
-5V: L7.1, L10.1, L13.1; also elsewhere on the board
-VDC: C108.2, C109.2, C110.2, C111.2, C112.2, C113.2, C118.2, C119.2, C120.2, C121.2, C122.2, C123.2, C124.2, C125.2, C126.2, C127.2, C128.2, C129.2, Q3.2 (S), Q5.2 (S), Q7.2 (S); also elsewhere on the board
GND2: C38.2, C39.2, C44.2, C45.2, C68.2, C71.2, U14.4 (GNDI), U15.4 (GNDI), U16.5 (DGND), U17.5 (DGND), U18.4 (GNDI), U19.5 (DGND); also elsewhere on the board
GND3: C40.2, C41.2, C69.2, L6.1, L9.1, L12.1; also elsewhere on the board
unnamed: D9.2 (A), R36.2
unnamed: C46.1, C50.1, D9.1 (K), R40.1, U14.16 (VDDA)
unnamed: D10.2 (A), R37.2
unnamed: C48.1, C54.1, D10.1 (K), R41.1, U15.16 (VDDA)
unnamed: C47.2, C51.2, D11.2 (A), U14.14 (GNDA)
unnamed: D11.1 (K), R38.2
unnamed: C49.2, C55.2, D12.2 (A), U15.14 (GNDA)
unnamed: D12.1 (K), R39.2
unnamed: C62.2, C64.2, D13.2 (A), Q2.2 (S), Q3.1 (D), R46.1, R48.1, U16.4 (AGND)
unnamed: C62.1, C64.1, D13.1 (K), R40.2, U16.1 (AVDD)
unnamed: C63.2, C65.2, D14.2 (A), Q4.2 (S), Q5.1 (D), R47.1, R49.1, U17.4 (AGND)
unnamed: C63.1, C65.1, D14.1 (K), R41.2, U17.1 (AVDD)
unnamed: D15.2 (A), R52.2
unnamed: C72.1, C74.1, D15.1 (K), R54.1, U18.16 (VDDA)
unnamed: C73.2, C75.2, D16.2 (A), U18.14 (GNDA)
unnamed: D16.1 (K), R53.2
unnamed: C80.2, C81.2, D17.2 (A), Q6.2 (S), Q7.1 (D), R57.1, R58.1, U19.4 (AGND)
unnamed: C80.1, C81.1, D17.1 (K), R54.2, U19.1 (AVDD)
unnamed: C46.2, C47.1, C50.2, C51.1, Q2.3 (DS)
unnamed: Q2.4 (G), R42.2
unnamed: C52.2, C53.1, C58.2, C59.1, L6.2, Q3.3 (DS)
unnamed: Q3.4 (G), R43.2
unnamed: C48.2, C49.1, C54.2, C55.1, Q4.3 (DS)
unnamed: Q4.4 (G), R44.2
unnamed: C56.2, C57.1, C60.2, C61.1, L9.2, Q5.3 (DS)
unnamed: Q5.4 (G), R45.2
unnamed: C72.2, C73.1, C74.2, C75.1, Q6.3 (DS)
unnamed: Q6.4 (G), R55.2
unnamed: C76.2, C77.1, C78.2, C79.1, L12.2, Q7.3 (DS)
unnamed: Q7.4 (G), R56.2
unnamed: C53.2, C59.2, L7.2, U14.9 (GNDB)
unnamed: R42.1, U14.15 (OUTA)
unnamed: R43.1, U14.10 (OUTB)
unnamed: C52.1, C58.1, L5.2, U14.11 (VDDB)
unnamed: C57.2, C61.2, L10.2, U15.9 (GNDB)
unnamed: R44.1, U15.15 (OUTA)
unnamed: R45.1, U15.10 (OUTB)
unnamed: C56.1, C60.1, L8.2, U15.11 (VDDB)
unnamed: C66.1, R46.2, U16.3 (AINN)
unnamed: C66.2, R50.2, U16.2 (AINP)
unnamed: C67.1, R47.2, U17.3 (AINN)
unnamed: C67.2, R51.2, U17.2 (AINP)
unnamed: C77.2, C79.2, L13.2, U18.9 (GNDB)
unnamed: R55.1, U18.15 (OUTA)
unnamed: R56.1, U18.10 (OUTB)
unnamed: C76.1, C78.1, L11.2, U18.11 (VDDB)
unnamed: C82.1, R57.2, U19.3 (AINN)
unnamed: C82.2, R59.2, U19.2 (AINP)
STO CH1: U14.5 (DISABLE), U15.5 (DISABLE), U18.5 (DISABLE); also elsewhere on the board
UH: TP8.1, U14.1 (INA); also elsewhere on the board
UL: TP10.1, U14.2 (INB); also elsewhere on the board
U_: R48.2, R50.1; also elsewhere on the board
U_CLOCK: U16.7 (CLKIN); also elsewhere on the board
U_DATA: TP12.1, U16.6 (DOUT); also elsewhere on the board
VBUS -5V: C42.2, C43.2, C70.2, R38.1, R39.1, R53.1; also elsewhere on the board
VH: TP9.1, U15.1 (INA); also elsewhere on the board
VL: TP11.1, U15.2 (INB); also elsewhere on the board
V_: R49.2, R51.1; also elsewhere on the board
V_CLOCK: U17.7 (CLKIN); also elsewhere on the board
V_DATA: TP13.1, U17.6 (DOUT); also elsewhere on the board
WH: TP14.1, U18.1 (INA); also elsewhere on the board
WL: TP15.1, U18.2 (INB); also elsewhere on the board
W_: R58.2, R59.1; also elsewhere on the board
W_CLOCK: U19.7 (CLKIN); also elsewhere on the board
W_DATA: TP16.1, U19.6 (DOUT); also elsewhere on the board

Notes on the sheet:
Phase V
Phase W
Phase U

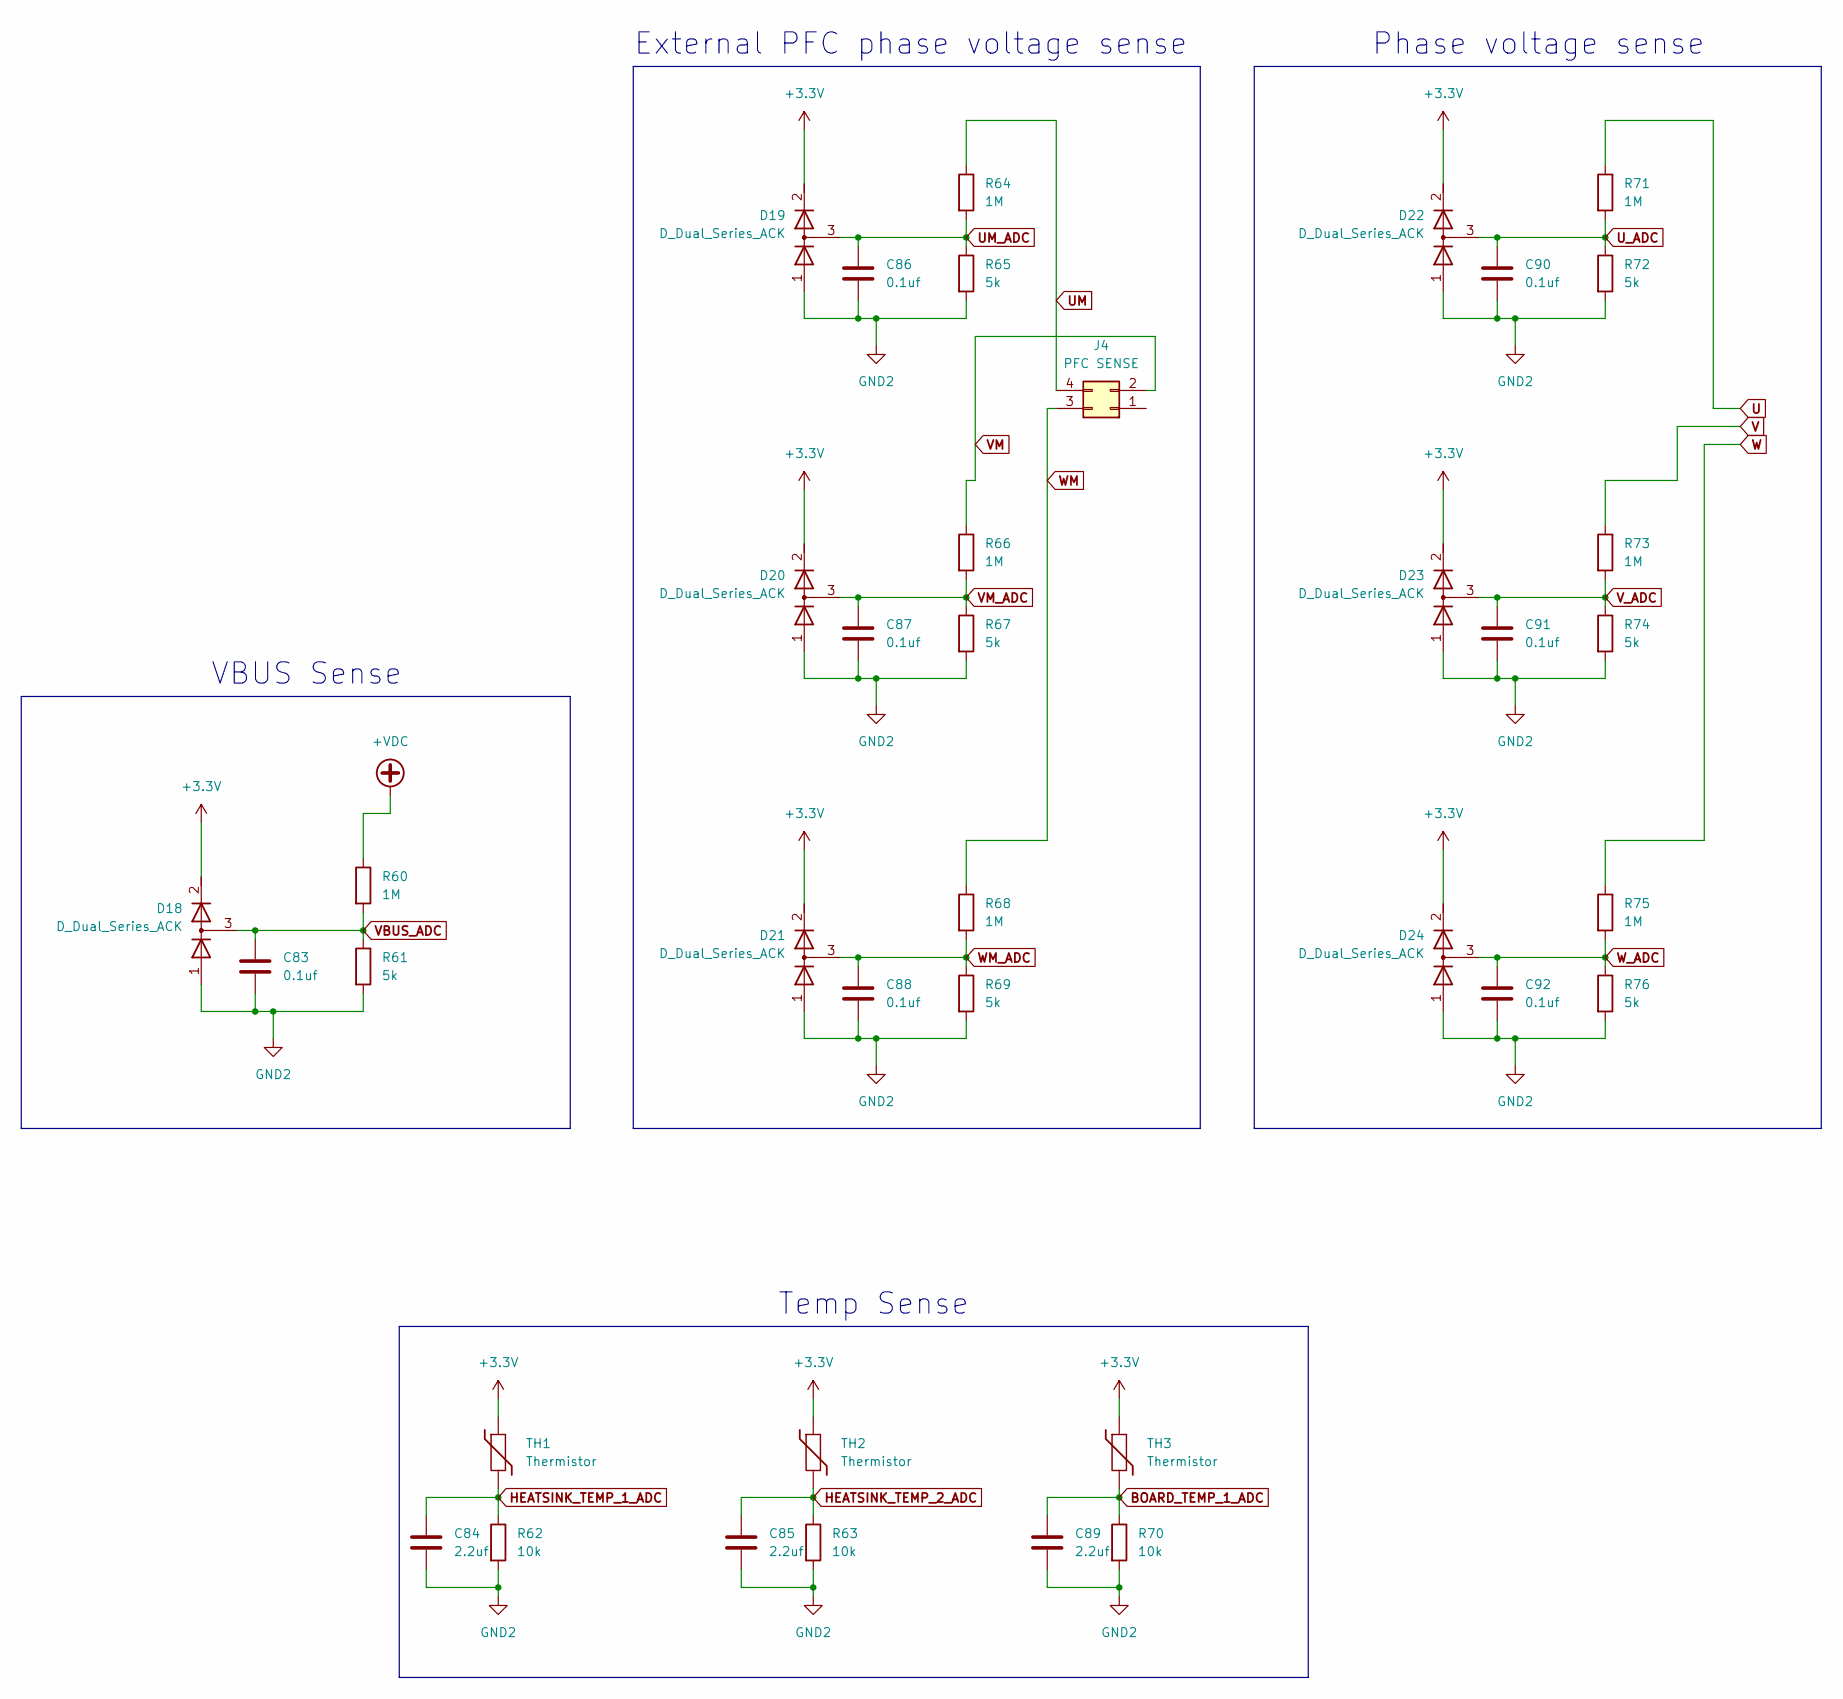
[picture p10: schematic adc sense.kicad_sch]

Parts:
C83, C86, C87, C88, C90, C91, C92: 0.1uf; C_0603_1608Metric
C84, C85, C89: 2.2uf; C_0603_1608Metric
D18, D19, D20, D21, D22, D23, D24: D_Dual_Series_ACK; SOT-23
J4: PFC SENSE; Molex_Mini-Fit_Jr_5569-04A2_2x02_P4.20mm_Horizontal
R60, R64, R66, R68, R71, R73, R75: 1M; R_Axial_DIN0309_L9.0mm_D3.2mm_P12.70mm_Horizontal
R61, R65, R67, R69, R72, R74, R76: 5k; R_0603_1608Metric
R62, R63, R70: 10k; R_0603_1608Metric
TH1, TH2: Thermistor; PinHeader_1x02_P2.54mm_Vertical
TH3: Thermistor; R_0603_1608Metric

Connections:
+3.3V: D18.2 (K), D19.2 (K), D20.2 (K), D21.2 (K), D22.2 (K), D23.2 (K), D24.2 (K), TH1.1, TH2.1, TH3.1; also elsewhere on the board
+VDC: R60.1; also elsewhere on the board
BOARD_TEMP_1_ADC: C89.1, R70.1, TH3.2; also elsewhere on the board
GND2: C83.2, C84.2, C85.2, C86.2, C87.2, C88.2, C89.2, C90.2, C91.2, C92.2, D18.1 (A), D19.1 (A), D20.1 (A), D21.1 (A), D22.1 (A), D23.1 (A), D24.1 (A), R61.2, R62.2, R63.2, R65.2, R67.2, R69.2, R70.2, R72.2, R74.2, R76.2; also elsewhere on the board
HEATSINK_TEMP_1_ADC: C84.1, R62.1, TH1.2; also elsewhere on the board
HEATSINK_TEMP_2_ADC: C85.1, R63.1, TH2.2; also elsewhere on the board
U: R71.1; also elsewhere on the board
UM: J4.4, R64.1
UM_ADC: C86.1, D19.3 (common), R64.2, R65.1; also elsewhere on the board
U_ADC: C90.1, D22.3 (common), R71.2, R72.1; also elsewhere on the board
V: R73.1; also elsewhere on the board
VBUS_ADC: C83.1, D18.3 (common), R60.2, R61.1; also elsewhere on the board
VM: J4.2, R66.1
VM_ADC: C87.1, D20.3 (common), R66.2, R67.1; also elsewhere on the board
V_ADC: C91.1, D23.3 (common), R73.2, R74.1; also elsewhere on the board
W: R75.1; also elsewhere on the board
WM: J4.3, R68.1
WM_ADC: C88.1, D21.3 (common), R68.2, R69.1; also elsewhere on the board
W_ADC: C92.1, D24.3 (common), R75.2, R76.1; also elsewhere on the board

Notes on the sheet:
VBUS Sense
External PFC phase voltage sense
Phase voltage sense
Temp Sense

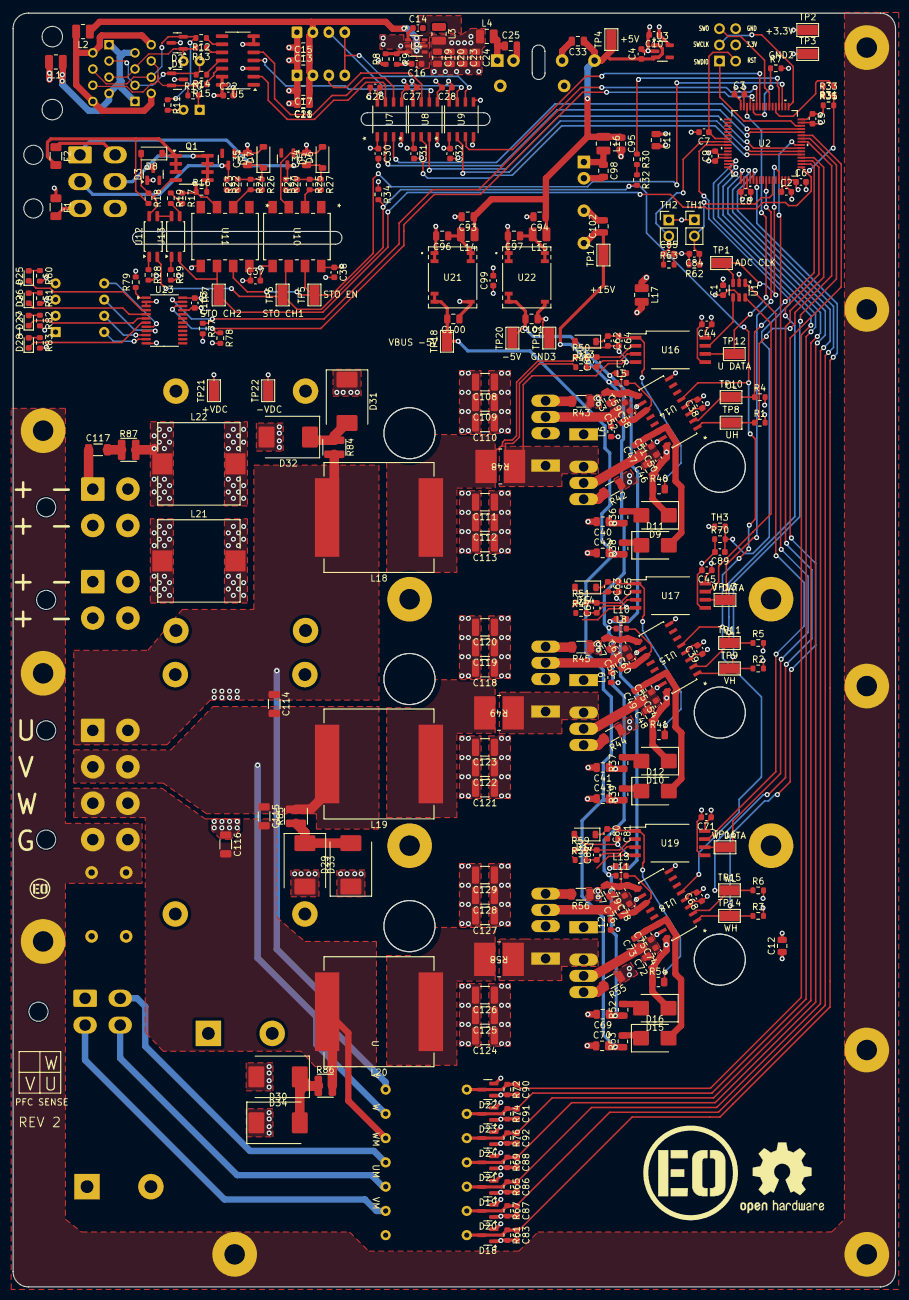
[picture p11: board HV servo drive v1.kicad_pcb from above]

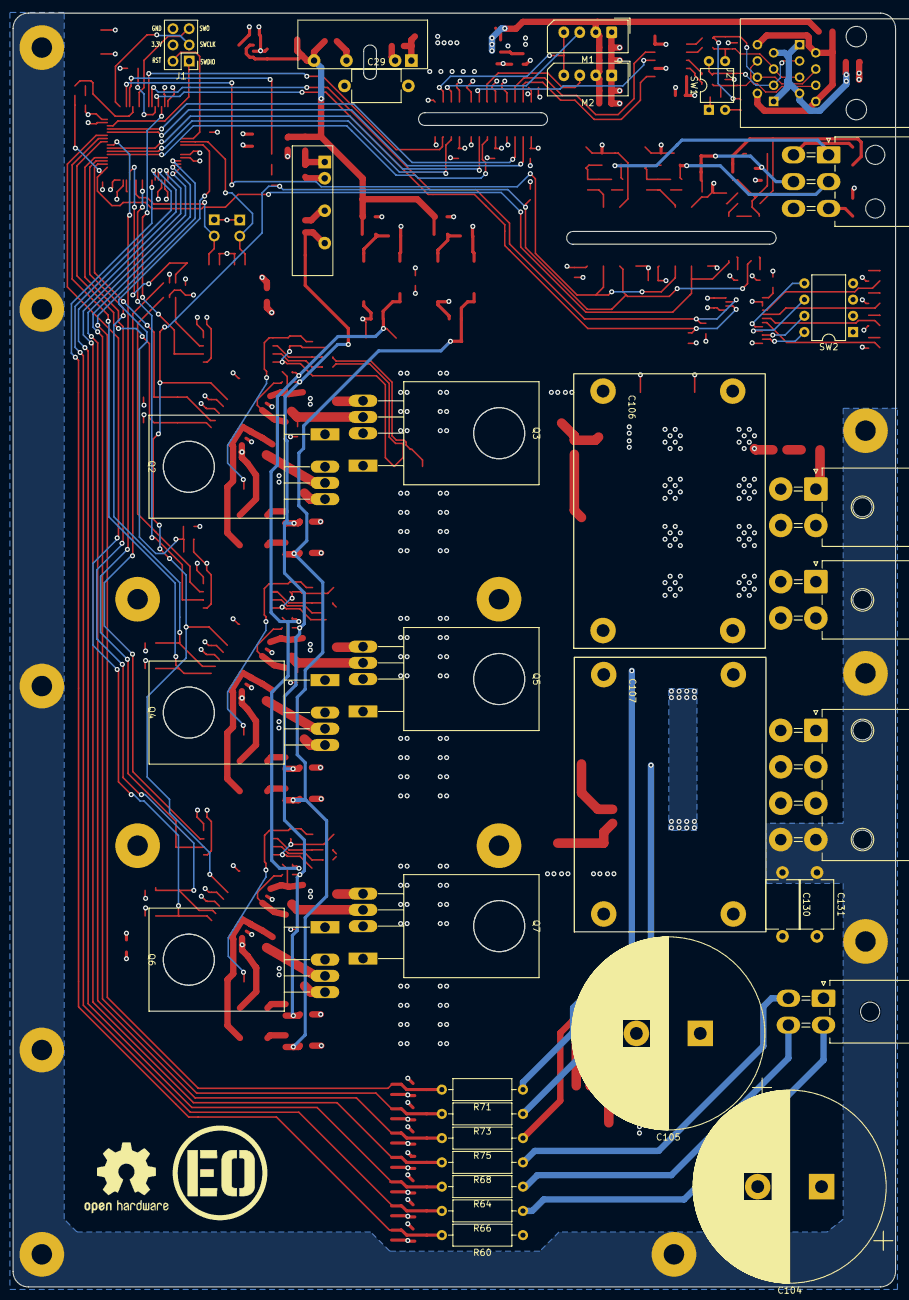
[picture p12: board HV servo drive v1.kicad_pcb from below]

Board: 4 copper layers, 138.2 x 199.5 mm, 355 parts (33 on the bottom side), 177 nets.
