ExcessiveOverkill/drive-software-dev/(commit log)

2024-04-03 add test PID GUI
2024-04-06 Added CubeIDE project for Nucleo Board to read encoder data and send to motor driver
2024-04-06 Create test GUI odrive.py
2024-04-30 Upload Final Demo
    Runs a demo to spin motor in open-loop mode at 20rad/s
2024-05-03 Pushing KiCAD files for physical PCB
    [HV servo drive v1 PCB.ipt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]
